CPSCourse-TUM-HN/TUM-HN-Team8_LeLamp/docs/slides/README.md

# Presentation slides

The course requires the slides **in PDF format**. Put the exported file here as:

```
docs/slides/Group8_CPS_Presentation.pdf
```

Keep the editable source (PowerPoint/Keynote/Google Slides export) next to it if you have one, e.g.
`Group8_CPS_Presentation.pptx`, so the deck can be revised later.

Suggested 15-minute structure:

1. Problem and idea (1 min)
2. System overview — hardware and software architecture (2 min)
3. What is upstream LeLamp vs. what Group 8 built (2 min)
4. Mechanical work: redesigned base, print-ready parts (2 min)
5. Perception → behaviour pipeline, voice integration (3 min)
6. Live demo / video (3 min)
7. Results, limitations, lessons learned (2 min)
