CPSCourse-TUM-HN/TUM-HN-Team8_LeLamp/docs/video/README.md

# Demonstration video

The course requires a video that demonstrates the project **in action**.

- If the file is small enough for git (< 100 MB), commit it here as
  `Group8_CPS_Demo.mp4`.
- Otherwise upload it (TUM OneDrive / YouTube unlisted / GitHub release asset) and put the link
  below, so the repository still satisfies "all materials uploaded to your GitHub repository".

**Video link:** _(to be added)_

Suggested content: powering up, camera detecting a person, the lamp reacting (motion + LED),
a voice interaction, and a short MuJoCo simulation clip showing how motions were developed.
