CPSCourse-TUM-HN/TUM-HN-Team8_LeLamp/docs/zh/0-前期准备.md

# 0. 前期准备

## 固定硬件清单

硬件型号和数量以当前使用的 profile 配置为准：Orin Nano Super 使用 `config/hardware.toml`，Jetson Nano 4GB 使用 `config/hardware.jetson-nano.toml`，不能随意替换。

默认 Orin Nano Super 配置：

| 子系统 | 型号 | 数量 |
| --- | --- | ---: |
| 主控 | NVIDIA Jetson Orin Nano Super Developer Kit, MPN `945-13766-0000-000` | 1 |
| 存储 | Samsung 980 NVMe M.2 2280 500GB, `MZ-V8V500B` | 1 |
| 系统卡 | SanDisk Ultra microSDXC 64GB UHS-I | 1 |
| 舵机 | Waveshare ST3215 Servo, 30kg.cm @ 12V, SKU `22414` | 5 |
| 舵机驱动 | Waveshare Servo Driver with ESP32, SKU `21593` | 1 |
| 舵机电源 | MEAN WELL `GST120A12-P1J`, 12V 10A 120W | 1 |
| LED 控制 | Raspberry Pi Pico WH | 1 |
| LED 面板 | Adafruit NeoPixel NeoMatrix 8x8, 64 RGB LED, Product ID `1487` | 1 |
| LED 电源 | MEAN WELL `GST60A05-P1J`, 5V 6A 30W | 1 |
| 电平转换 | TXS0108E 8-Channel Logic Level Converter Module | 1 |
| LED 电阻 | 330 ohm 1/4W resistor | 5 |
| LED 电容 | 1000 uF 6.3V or 10V electrolytic capacitor | 2 |
| 摄像头 | Arducam `UB0234`, 2MP OV2710 USB2.0 UVC Camera, 1080p, M12 lens | 1 |
| 音频 | Seeed Studio ReSpeaker XVF3800 USB 4-Mic Array with Case, Product `6490` | 1 |
| 扬声器 | Seeed Studio Mono Enclosed Speaker, 4 ohm 5W | 1 |
| 急停开关 | 12V 10A DC inline switch / emergency stop switch | 1 |
| USB 线 | USB-A to USB-C data cable, 0.5m | 1 |
| USB 线 | USB-A to Micro-USB data cable, 0.5m | 1 |
| USB 延长线 | USB-A extension cable, 0.3m or 0.5m | 1 |
| 舵机延长线 | ST / SC serial bus servo extension cable | 5 |
| 电源端子 | 5.5mm x 2.1mm DC barrel screw terminal adapter | 4 |
| 电源连接器 | WAGO 221-413 lever connector | 10 |
| 红色电源线 | 22AWG red silicone wire | 2m |
| 黑色电源线 | 22AWG black silicone wire | 2m |
| 信号线 | 24AWG silicone wire | 2m |

Jetson Nano 4GB API-hybrid 配置改动：

| 子系统 | 型号 | 数量 |
| --- | --- | ---: |
| 主控 | NVIDIA Jetson Nano Developer Kit 4GB, MPN `945-13450-0000-100` | 1 |
| 存储 | basic Jetson Nano Developer Kit 不使用 NVMe，使用 microSD 启动 | 0 |
| 系统卡 | SanDisk Ultra microSDXC 64GB UHS-I | 1 |

舵机、LED、摄像头、音频、电源、线材和连接器保持默认清单不变。

## 电源域

```text
Jetson 电源 -> 只给 Jetson
GST120A12-P1J -> Waveshare Servo Driver with ESP32 -> 5x ST3215
GST60A05-P1J -> Adafruit NeoPixel NeoMatrix 8x8
Jetson USB -> Pico WH 控制信号，不给 LED 供电
```

## 默认端口

```text
/dev/ttyACM0 -> Waveshare 舵机驱动板
/dev/ttyACM1 -> Raspberry Pi Pico WH
/dev/video0  -> Arducam UB0234
USB audio    -> ReSpeaker XVF3800
```
