CPSCourse-TUM-HN/TUM-HN-Team8_LeLamp/docs/zh/2-舵机设置.md

# 2. 舵机设置

固定 ID：

```text
base_yaw=1
base_pitch=2
elbow_pitch=3
wrist_roll=4
wrist_pitch=5
```

测试：

```bash
ailamp motor-test
```

校准沿用 LeLamp runtime：

```bash
cd ~/projects
git clone https://github.com/humancomputerlab/lelamp_runtime.git
cd ~/projects/AILamp
python3 -m pip install -e ../lelamp_runtime
python3 -m lelamp.setup_motors --id ailamp --port /dev/ttyACM0
sudo python3 -m lelamp.calibrate --id ailamp --port /dev/ttyACM0
```

ST3215 总线只使用 MEAN WELL `GST120A12-P1J` 供电，不从 Jetson USB 给舵机供电。
