CPSCourse-TUM-HN/TUM-HN-Team8_LeLamp/docs/zh/4-运行环境.md

# 4. 运行环境

```bash
cd ~/projects/AILamp
python3 -m venv .venv
source .venv/bin/activate
pip install -e ".[hardware,simulation,voice,test]"
```

Jetson Nano 4GB API-hybrid 安装：

```bash
cd ~/projects/AILamp
python3.11 -m venv .venv
source .venv/bin/activate
pip install -e ".[nano,test]"
export OPENAI_API_KEY=...
```

Jetson Nano 配置下不要在 Nano 上安装本地 YOLO pose、MuJoCo 或本地大模型。

检测：

```bash
ailamp runtime-check
ailamp hardware-check
ailamp hardware-check --include-devices
ailamp --config config/hardware.jetson-nano.toml runtime-check
ailamp --config config/hardware.jetson-nano.toml runtime-check --include-devices --include-voice
ailamp --config config/hardware.jetson-nano.toml hardware-check
ailamp --config config/hardware.jetson-nano.toml hardware-check --include-devices
```

`runtime-check` 会检查 Python 入口、动作 recording、Pico 固件文件、`outputs/` 是否可写，以及 Jetson Nano API-hybrid 配置下的 `OPENAI_API_KEY`。安装 LeLamp 上游运行时后，可以加 `--include-motor-runtime` 检查舵机运行时。

Pico WH 固件在：

```text
firmware/pico_led_controller/code.py
```

Pico WH 要求：

```text
Raspberry Pi Pico WH 使用 CircuitPython 9.x
/lib 中放入 adafruit-circuitpython-neopixel 库
NeoMatrix 数据线接 Pico GP0
Pico GP0 与 NeoMatrix DIN 之间使用 TXS0108E 电平转换
```

串口协议：

```text
PING
CLEAR
SOLID r g b
BRIGHTNESS value
PIXELS r,g,b;r,g,b
```

## Jetson Nano 验收流程

在 Jetson Nano 上按这个顺序运行：

```bash
ailamp --config config/hardware.jetson-nano.toml runtime-check
ailamp --config config/hardware.jetson-nano.toml hardware-check --include-devices
ailamp --config config/hardware.jetson-nano.toml camera-test
ailamp --config config/hardware.jetson-nano.toml audio-test
ailamp --config config/hardware.jetson-nano.toml led-test
ailamp --config config/hardware.jetson-nano.toml motor-test
ailamp --config config/hardware.jetson-nano.toml agent-tools-test --event person_right --offset 0.6 --request "看着我并跟随我"
ailamp --config config/hardware.jetson-nano.toml vision-loop --frames 30
```

全部通过后再运行真实输出：

```bash
ailamp --config config/hardware.jetson-nano.toml vision-loop --with-outputs
ailamp --config config/hardware.jetson-nano.toml agent --with-outputs
```
