CPSCourse-TUM-HN/TUM-HN-Team8_LeLamp/docs/zh/5-控制视觉仿真.md

# 5. 控制、视觉与仿真

仿真：

```bash
ailamp sim-check
ailamp sim-check --render outputs/sim_check.png
ailamp sim-check --render outputs/ailamp_current_mesh_sim.png --camera ailamp_overview_camera
ailamp sim-demo
ailamp sim-viewer --render outputs/ailamp.png
```

AILamp 保持原 LeLamp 的仿真流程：

```text
仿真软件：MuJoCo
主场景：simulation/ailamp_scene.xml
原始参考场景：simulation/scene.xml
机器人 MJCF：simulation/ailamp_robot.xml，从 `simulation/robot.xml` 生成并移除原始底座 mesh
参考 URDF：simulation/robot.urdf
网格资产：simulation/assets/*.stl
```

`simulation/ailamp_scene.xml` 包含派生的 LeLamp MJCF、虚拟人物目标、仿真摄像头，以及用于 Jetson Nano 开发板的 AILamp 替换底座。派生 MJCF 会移除原 `lamp_base` 和 `lamp_base_cover` mesh。固定壳体/上盖保留在 scene 中，`ailamp_base_arm_link_boot_visual` 会插回原 LeLamp 上盖 transform，让灯臂根部有一个随动过渡件，而不是直接穿过固定开口。

场景中的适配件可视对象：

```text
ailamp_integrated_base_shell_visual -> 替换版 LampBase 电子仓壳体
ailamp_integrated_base_cover_visual -> 替换版 LampBase 上盖
ailamp_base_arm_link_boot_visual -> 随动底座-灯臂过渡靴
ailamp_cable_clip_6mm_visual -> USB/信号线夹
ailamp_cable_clip_10mm_visual -> 电源/舵机线夹
```

这些适配件 mesh 只作为底座电子件布局参考，不改变 LeLamp 舵机运动链、灯头几何或 actuator 映射。

整体台灯渲染使用 `ailamp_overview_camera`，虚拟人物交互视角使用 `ailamp_sim_camera`。

`sim-check` 是推荐的非交互仿真验收命令，会检查模型加载、5 个 actuator 映射、root freejoint 锁定、适配件可视几何、虚拟人物事件和核心 recording 回放。

真实硬件：

```bash
ailamp camera-test
ailamp audio-test
ailamp led-test
ailamp vision-demo
ailamp vision-loop --frames 30
ailamp vision-loop --with-outputs
ailamp agent-tools-test --event person_close --apply
ailamp agent-tools-test --event posture_studying --apply
ailamp agent-tools-test --event person_right --offset 0.6 --request "看着我并跟随我" --apply
ailamp agent
ailamp agent --with-outputs
```

事件映射：

```text
no_person -> scanning -> 深蓝
person_left -> headshake -> 蓝色
person_center -> nod -> 暖色
person_right -> scanning -> 蓝色
person_close -> shy -> 粉红
person_far -> curious -> 绿色
person_left_seat -> idle -> 深蓝
gesture_left -> headshake -> 蓝色
gesture_right -> scanning -> 蓝色
gesture_up -> curious -> 冷白蓝
gesture_down -> idle -> 冷白蓝
posture_studying -> idle -> 专注暖白
looking_at_lamp -> nod -> 暖色
expression_smile -> happy_wiggle -> 暖色
expression_tired -> idle -> 专注暖白
expression_neutral -> idle -> 冷白蓝
```

`vision-demo` 只抓取一帧，打印识别事件、动作和灯光颜色。

`vision-loop` 是连续运行的真实闭环。

Orin 配置：

```text
Arducam UB0234 -> YOLO nano + YOLO pose -> VisionEvent -> DecisionService -> ST3215 + Pico LED
```

Jetson Nano API-hybrid 配置：

```text
Arducam UB0234 -> 低频 OpenAI vision API -> VisionEvent -> DecisionService -> ST3215 + Pico LED
```

默认只打印结果并写入 `outputs/vision_state.json`。在 Jetson 上确认 `led-test` 和 `motor-test` 通过后，再使用 `--with-outputs` 驱动真实舵机和 LED。

```bash
ailamp --config config/hardware.jetson-nano.toml vision-loop --with-outputs
```

## AI 决策层

AILamp 在视觉/语音输入和硬件输出之间加入了本地决策层：

```text
VisionEvent + 可选语音请求 -> DecisionService -> 动作 recording 或关节增量 + LED
```

连续跟随决策：

```text
person_left / gesture_left -> base_yaw 负向增量，慢慢向左
person_right / gesture_right -> base_yaw 正向增量，慢慢向右
person_close -> wrist_pitch 负向增量，灯头轻微后仰
person_far -> wrist_pitch 正向增量，灯头前倾
gesture_up -> wrist_pitch 正向增量
gesture_down -> wrist_pitch 负向增量
```

语音意图可以覆盖默认视觉反应：

```text
"专注" / "学习" / "focus" / "study" -> idle + 专注暖白灯
"点头" / "nod" -> nod
"跟随" / "看着我" / "follow" / "track" -> 连续跟随
"休息" / "待机" / "idle" / "rest" -> idle
```

关节增量命令在发送给 ST3215 层前会经过安全限幅。

当前手势与姿态支持使用启发式规则：

- 手向左/右/上/下会触发对应方向的灯位调整反应
- 低头学习会开启专注暖白灯光
- 抬头看台灯会触发点头回应
- 人靠近镜头优先触发 `shy`
- 人离开座位会切换到 `idle`

如果希望 AI 工具使用实时摄像头状态，需要同时运行 `vision-loop` 和 `agent`。LiveKit/OpenAI agent 读取同一个 `outputs/vision_state.json`，工具能力包括：

`ailamp agent` 默认使用 dry-run 动作和灯光输出。只有在 Jetson Nano 硬件验收流程通过后，才使用 `ailamp agent --with-outputs` 驱动真实硬件。

- 描述可用工具
- 根据视觉和语音意图做决策
- 读取当前视觉状态
- 给出当前视觉状态对应的动作和灯光
- 将当前视觉行为应用到真实台灯
- 列出可用动作 recording
- 播放指定动作 recording
- 设置自定义 LED 颜色

`agent-tools-test` 会调用同一套 AI 可用工具，不需要 LiveKit 或真实硬件，默认使用 dry-run 输出：

```bash
ailamp agent-tools-test --event person_close --apply --recording nod --color 1 2 3
ailamp agent-tools-test --event posture_studying --apply
ailamp agent-tools-test --event person_right --offset 0.6 --request "看着我并跟随我" --apply
```
