CPSCourse-TUM-HN/TUM-HN-Team8_LeLamp/docs/zh/7-生日提醒.md

# 7. 生日提醒

AILamp 不使用隐藏后门。生日提醒是显式配置项，位于 `config/hardware.toml`：

```toml
[birthday]
enabled = true
month = 5
day = 8
message = "Happy birthday, Yugu!"
motion = "happy_wiggle"
rgb = [255, 180, 80]
state_file = "outputs/birthday_state.json"
speech_command = "auto"
```

本地测试：

```bash
ailamp birthday-check --today 2026-05-08 --dry-run
ailamp birthday-check --today 2026-05-08 --force --speak
```

Jetson 自动运行：

```bash
sudo cp deploy/systemd/ailamp-birthday.service /etc/systemd/system/
sudo cp deploy/systemd/ailamp-birthday.timer /etc/systemd/system/
sudo systemctl daemon-reload
sudo systemctl enable --now ailamp-birthday.timer
```

部署前把 service 文件中的 `/opt/AILamp` 改成实际项目路径。timer 每天运行一次，CLI 只会在配置日期触发，并通过 `state_file` 防止同一天重复播放。
