CPSCourse-TUM-HN/TUM-HN-Team8_LeLamp/TEAM.md

# Group 8 — team and roles

| Name | TUM e-mail | GitHub | Responsibility |
|---|---|---|---|
| Yu Gu | yu.gu@tum.de | YuGu0358 | *(fill in)* |
| *(name)* | | | |
| *(name)* | | | |
| *(name)* | | | |
| *(name)* | | | |
| *(name)* | | | |
| *(name)* | | | |

Course: Embedded Systems, Cyber-Physical Systems and Robotics (INHN0018), TUM Campus Heilbronn, S2026.
Teaching team: Prof. Amr Alanwar · Hadi Elnemr · Moaaz Eid · Ahmad Hafez · Peng Xie.
