CPSCourse-TUM-HN/TUM-HN-Team8_LeLamp/docs/media/ailamp_mujoco_topdown.png

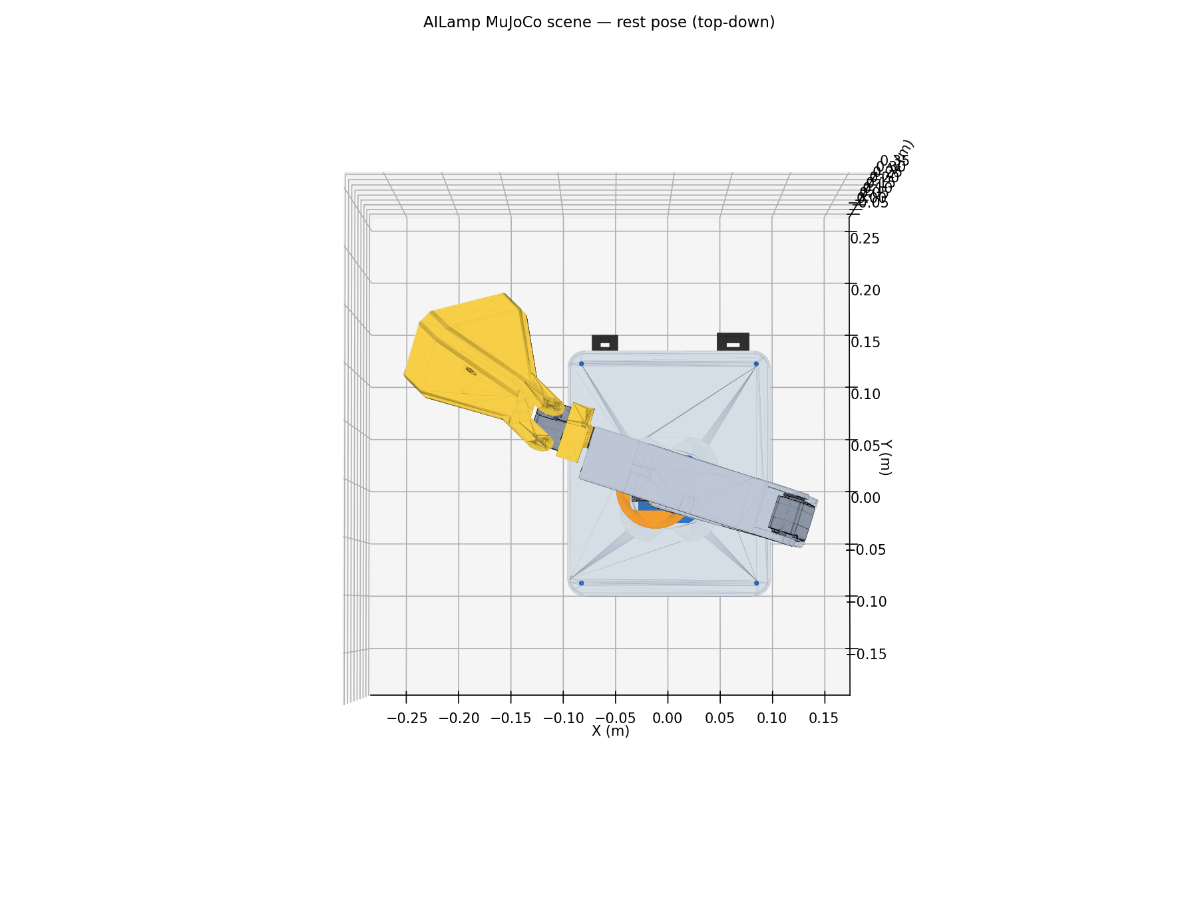
docs/media/ailamp_mujoco_topdown.png
