CPSCourse-TUM-HN/TUM-HN-Team8_LeLamp/docs/media/ailamp_optimized_base_exploded.png

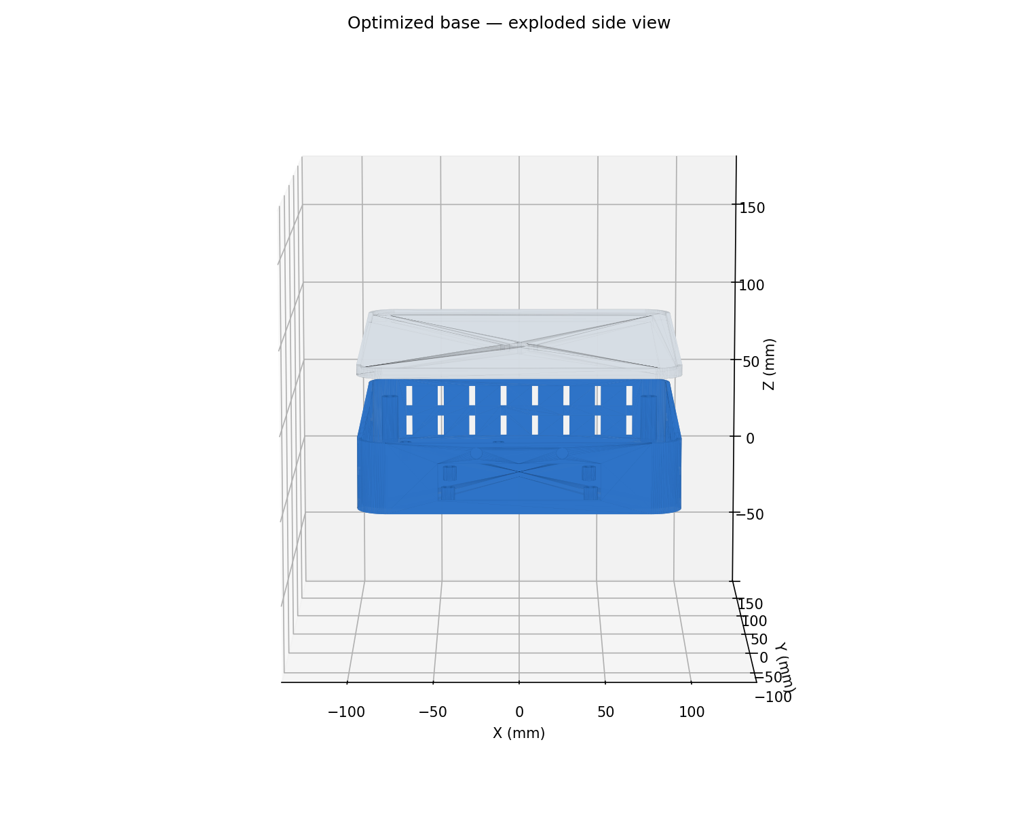
docs/media/ailamp_optimized_base_exploded.png
