CPSCourse-TUM-HN/TUM-HN-Team8_LeLamp/docs/media/ailamp_optimized_shell_cavity.png

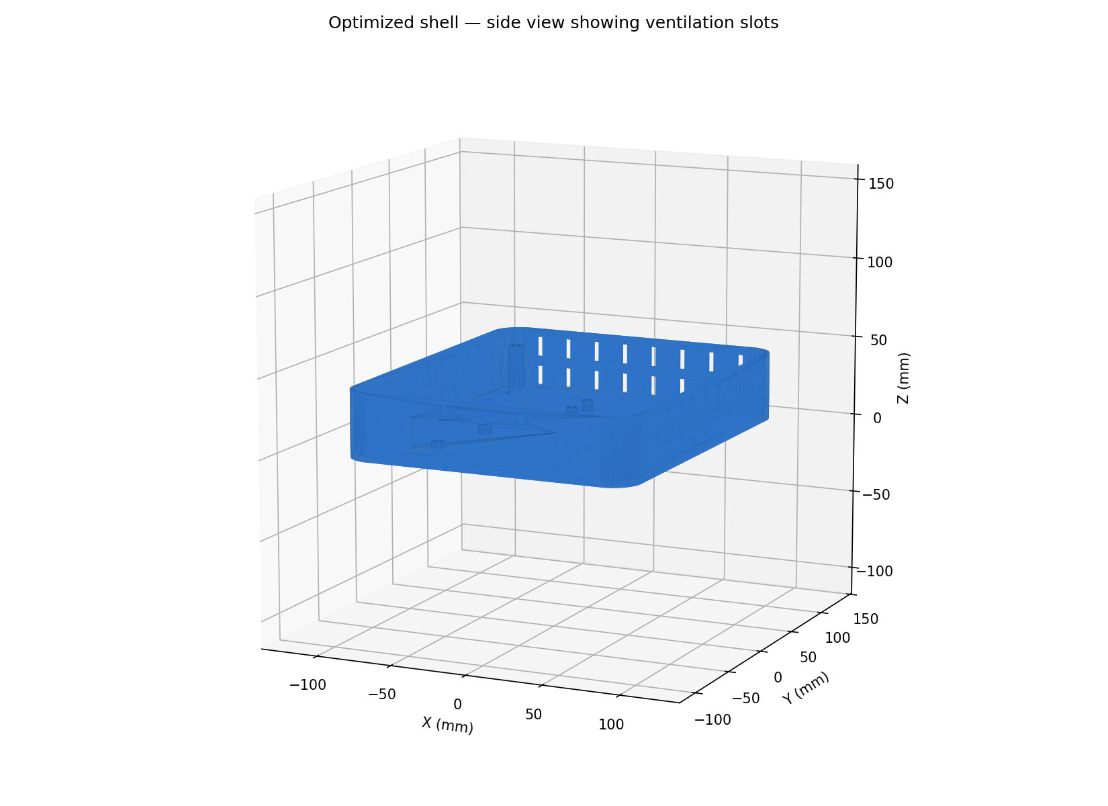
docs/media/ailamp_optimized_shell_cavity.png
