CPSCourse-TUM-HN/TUM-HN-Team8_LeLamp/docs/media/pose_idle.png

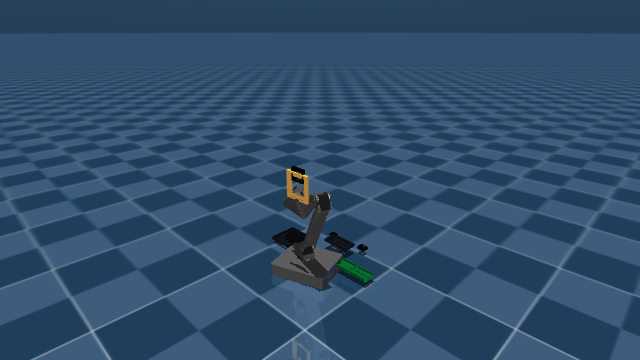
docs/media/pose_idle.png
