CPSCourse-TUM-HN/TUM-HN-Team8_LeLamp/3D/AILamp_Adapters/AILamp_Electronics_Side_Deck.3mf

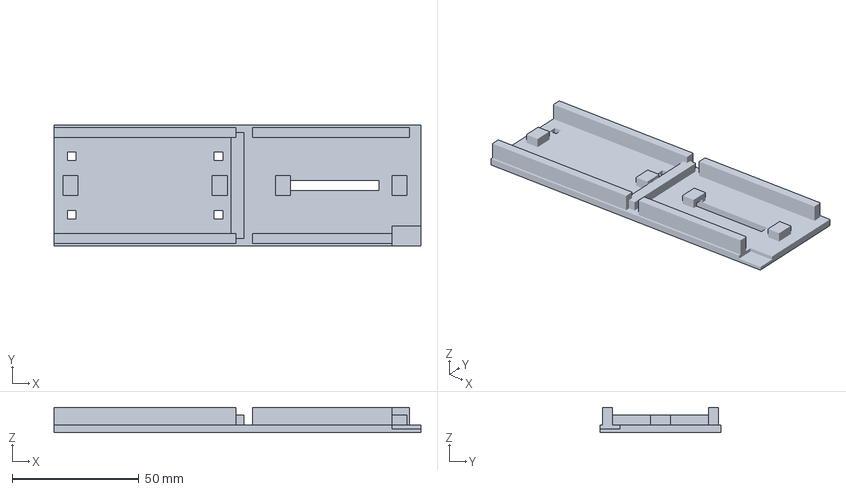
[picture p7: CAD file, 2026-08-31]
3D/AILamp_Adapters/AILamp_Electronics_Side_Deck.3mf
145.0 x 48.0 x 10.0 mm
