CPSCourse-TUM-HN/TUM-HN-Team8_LeLamp/3D/LampBase.3mf

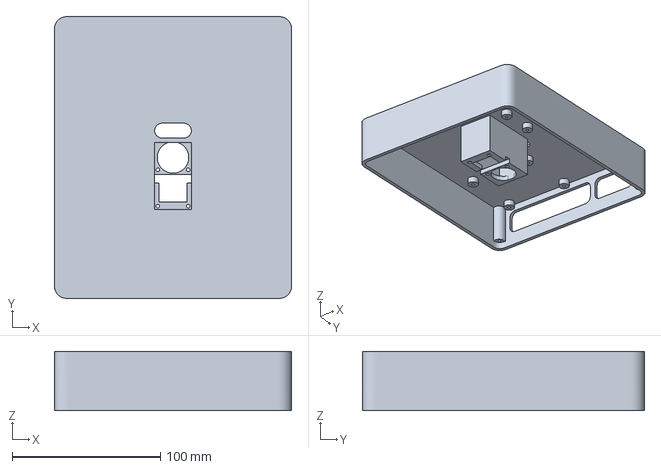
[picture p8: CAD file, 2026-08-31]
3D/LampBase.3mf
160.0 x 190.0 x 40.0 mm
