CPSCourse-TUM-HN/TUM-HN-Team8_LeLamp/3D/print_ready/AILamp_Current_3D_Print_Files/Required_3MF/LampHead.3mf

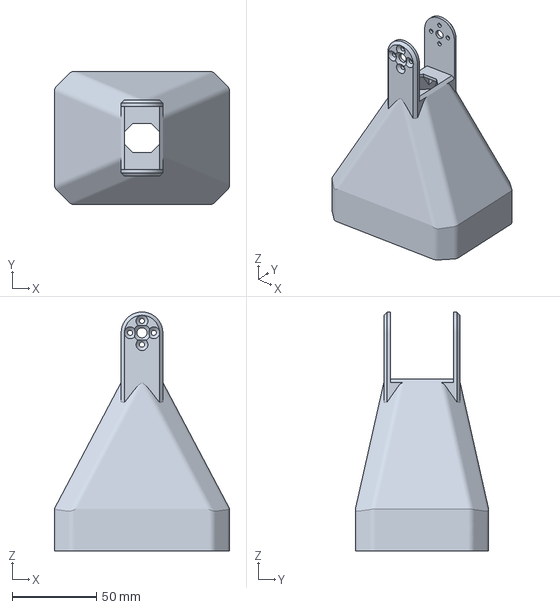
[picture p9: CAD file, 2026-08-31]
3D/print_ready/AILamp_Current_3D_Print_Files/Required_3MF/LampHead.3mf
104.0 x 79.0 x 141.7 mm
