CPSCourse-TUM-HN/TUM-HN-Team8_LeLamp/simulation/assets/ge_27.stl

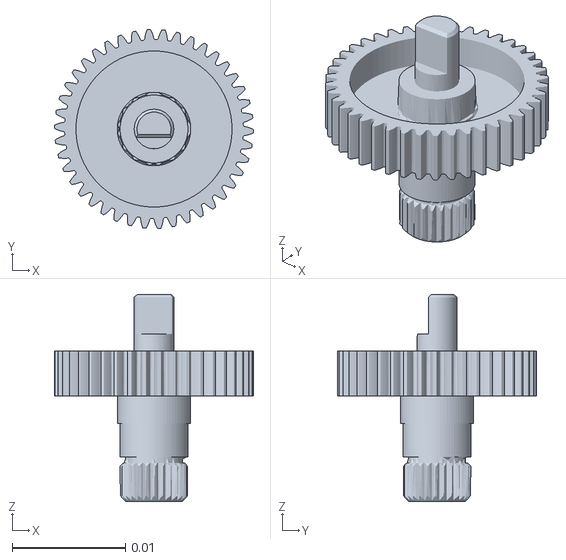
[picture p10: CAD file, 2026-08-31]
simulation/assets/ge_27.stl
0.0176 x 0.0176 x 0.0183
