CPSCourse-TUM-HN/TUM-HN-Team8_LeLamp/3D/AILamp_Adapters/AILamp_Base_Arm_Link_Boot.3mf

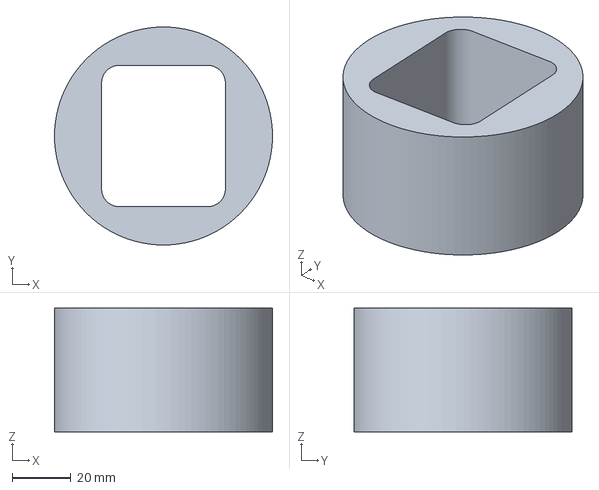
[picture p11: CAD file, 2026-08-31]
3D/AILamp_Adapters/AILamp_Base_Arm_Link_Boot.3mf
74.0 x 74.0 x 42.0 mm
