CPSCourse-TUM-HN/TUM-HN-Team8_LeLamp/3D/LampBase - Cover.3mf

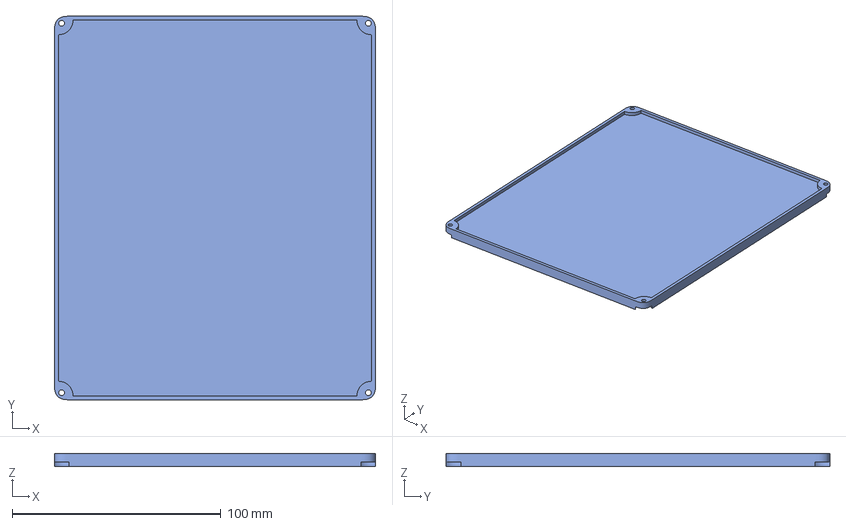
[picture p12: CAD file, 2026-08-31]
3D/LampBase - Cover.3mf
153.8 x 183.8 x 6.00 mm
