CPSCourse-TUM-HN/TUM-HN-Team8_LeLamp/3D/print_ready/AILamp_Current_3D_Print_Files/Optional_3MF/AILamp_Jetson_Nano_Base_Tray.3mf

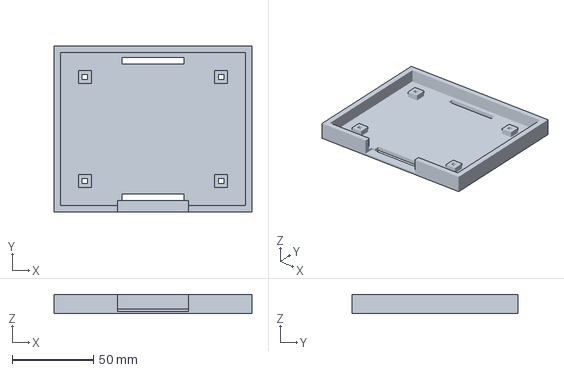
[picture p13: CAD file, 2026-08-31]
3D/print_ready/AILamp_Current_3D_Print_Files/Optional_3MF/AILamp_Jetson_Nano_Base_Tray.3mf
122.0 x 102.0 x 12.0 mm
