CPSCourse-TUM-HN/TUM-HN-Team8_LeLamp/3D/print_ready/AILamp_Current_3D_Print_Files/Required_3MF/AILamp_LampBase_Electronics_Cover.3mf

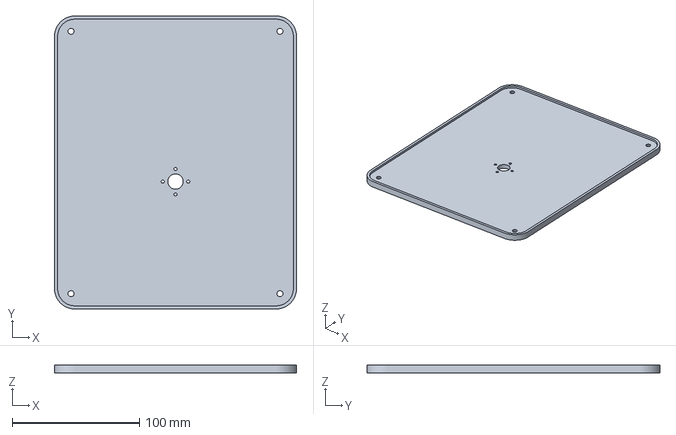
[picture p14: CAD file, 2026-08-31]
3D/print_ready/AILamp_Current_3D_Print_Files/Required_3MF/AILamp_LampBase_Electronics_Cover.3mf
190.0 x 230.0 x 6.00 mm
