CPSCourse-TUM-HN/TUM-HN-Team8_LeLamp/3D/print_ready/AILamp_Current_3D_Print_Files/STL_Exports/AILamp_LampBase_Electronics_Shell.stl

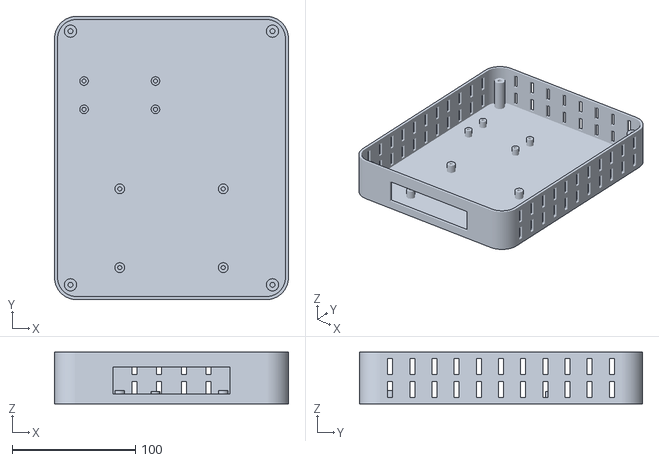
[picture p15: CAD file, 2026-08-31]
3D/print_ready/AILamp_Current_3D_Print_Files/STL_Exports/AILamp_LampBase_Electronics_Shell.stl
190.0 x 230.0 x 42.0
