CPSCourse-TUM-HN/TUM-HN-Team8_LeLamp/simulation/assets/ailamp_adapters/AILamp_Cable_Clip_6mm.stl

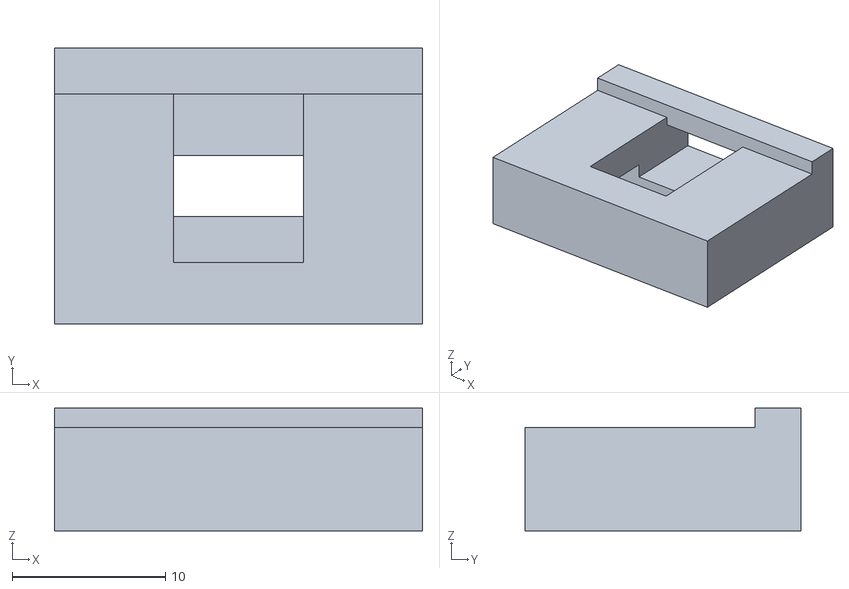
[picture p16: CAD file, 2026-08-31]
simulation/assets/ailamp_adapters/AILamp_Cable_Clip_6mm.stl
24.0 x 18.0 x 8.00
