CPSCourse-TUM-HN/TUM-HN-Team8_LeLamp/simulation/assets/motor_1723_3.stl

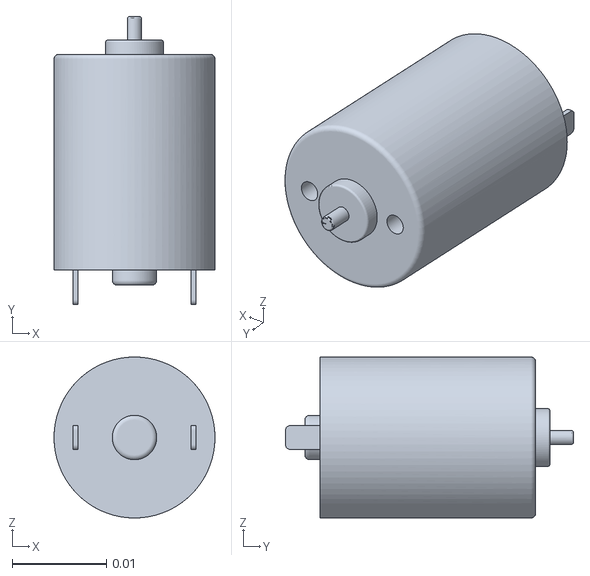
[picture p17: CAD file, 2026-08-31]
simulation/assets/motor_1723_3.stl
0.017 x 0.0305 x 0.017
