CPSCourse-TUM-HN/TUM-HN-Team8_LeLamp/3D/LampArm (Pitch).3mf

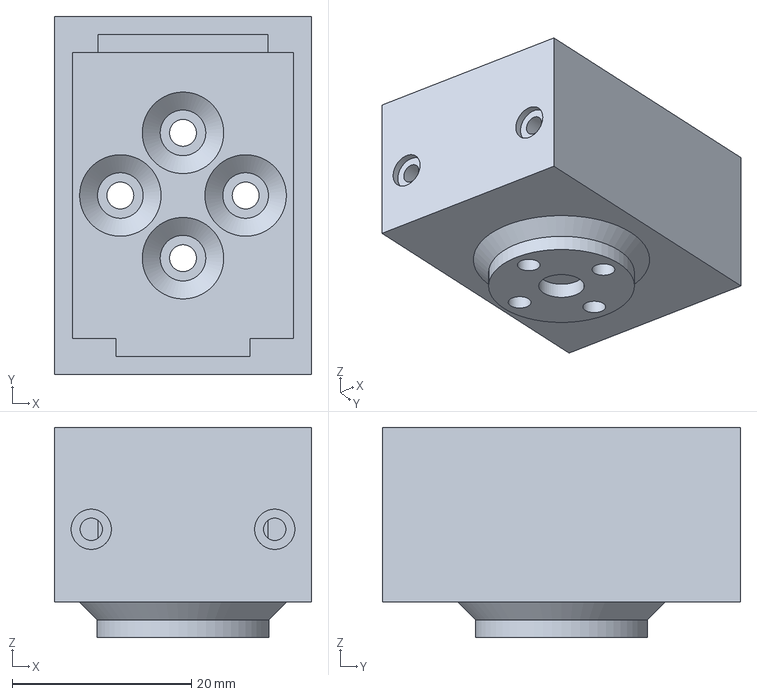
[picture p18: CAD file, 2026-08-31]
3D/LampArm (Pitch).3mf
28.7 x 40.0 x 23.5 mm
