CPSCourse-TUM-HN/TUM-HN-Team8_LeLamp/3D/print_ready/AILamp_Current_3D_Print_Files/Required_3MF/LampHead - Diffuser.3mf

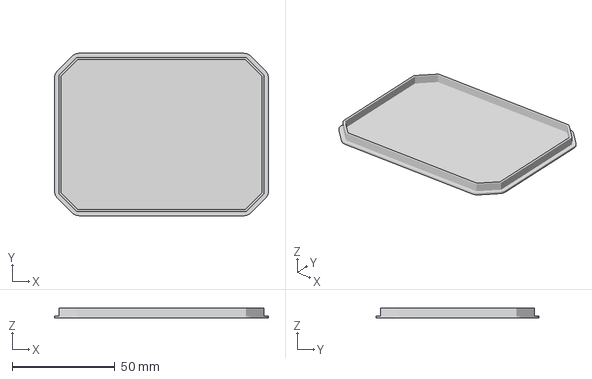
[picture p19: CAD file, 2026-08-31]
3D/print_ready/AILamp_Current_3D_Print_Files/Required_3MF/LampHead - Diffuser.3mf
104.0 x 79.0 x 5.00 mm
