CPSCourse-TUM-HN/TUM-HN-Team8_LeLamp/3D/print_ready/AILamp_Current_3D_Print_Files/STL_Exports/AILamp_Cable_Clip_10mm.stl

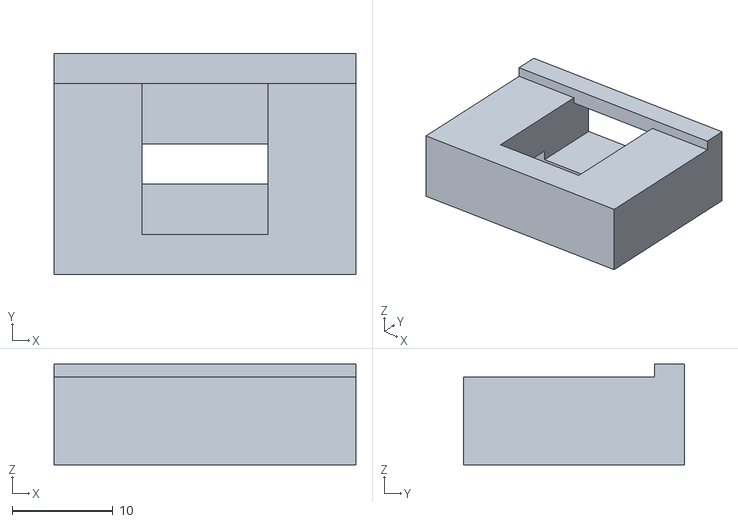
[picture p20: CAD file, 2026-08-31]
3D/print_ready/AILamp_Current_3D_Print_Files/STL_Exports/AILamp_Cable_Clip_10mm.stl
30.0 x 22.0 x 10.0
