CPSCourse-TUM-HN/TUM-HN-Team8_LeLamp/simulation/assets/xg_ziji_16.stl

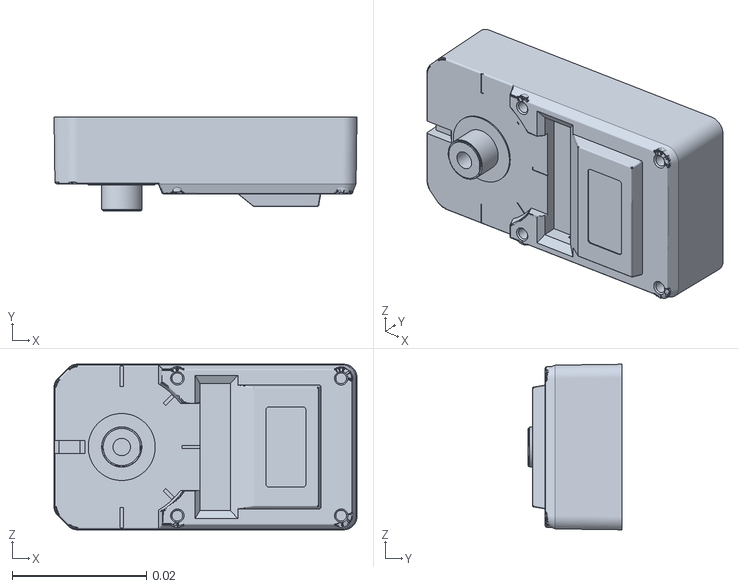
[picture p21: CAD file, 2026-08-31]
simulation/assets/xg_ziji_16.stl
0.0452 x 0.0141 x 0.0247
