CPSCourse-TUM-HN/TUM-HN-Team8_LeLamp/3D/LampArm (Elbow-Wrist).3mf

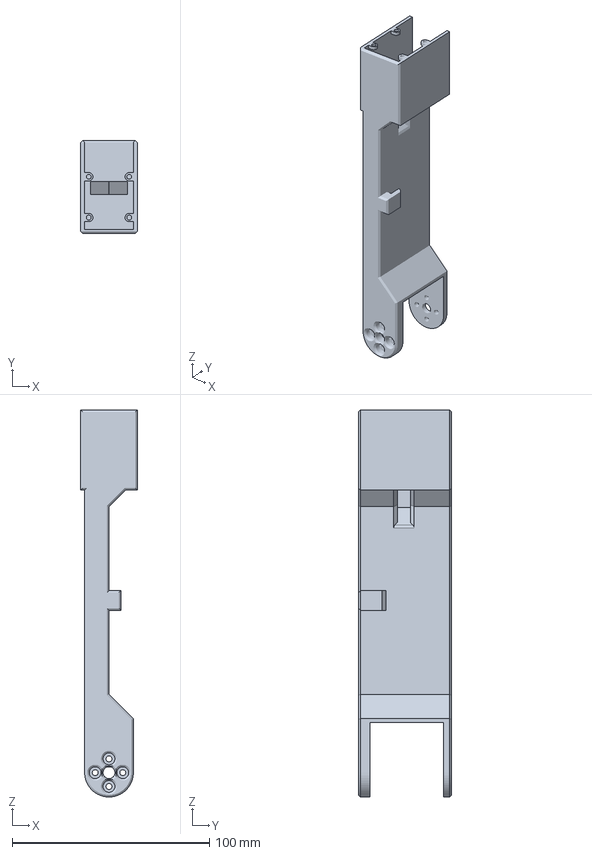
[picture p22: CAD file, 2026-08-31]
3D/LampArm (Elbow-Wrist).3mf
28.7 x 47.2 x 196.3 mm
