CPSCourse-TUM-HN/TUM-HN-Team8_LeLamp/3D/print_ready/AILamp_Current_3D_Print_Files/Required_3MF/LampArm (Base-Elbow).3mf

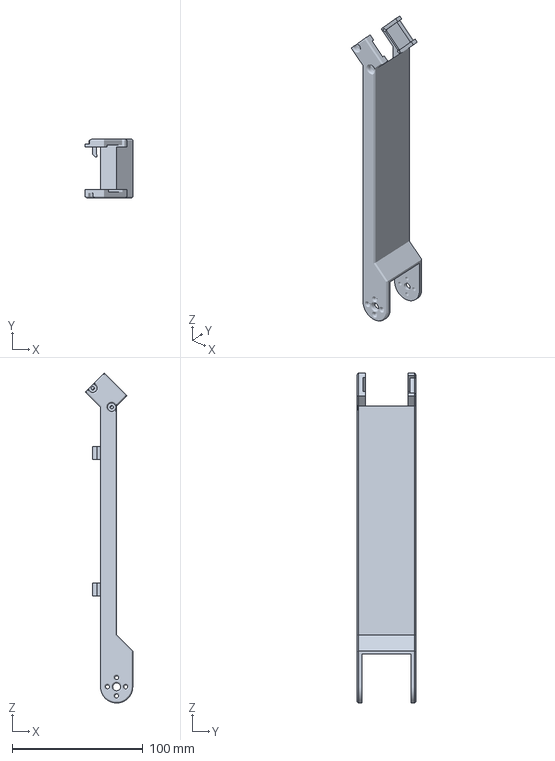
[picture p23: CAD file, 2026-08-31]
3D/print_ready/AILamp_Current_3D_Print_Files/Required_3MF/LampArm (Base-Elbow).3mf
36.4 x 45.2 x 252.7 mm
