CPSCourse-TUM-HN/TUM-HN-Team8_LeLamp/simulation/assets/diffuser.stl

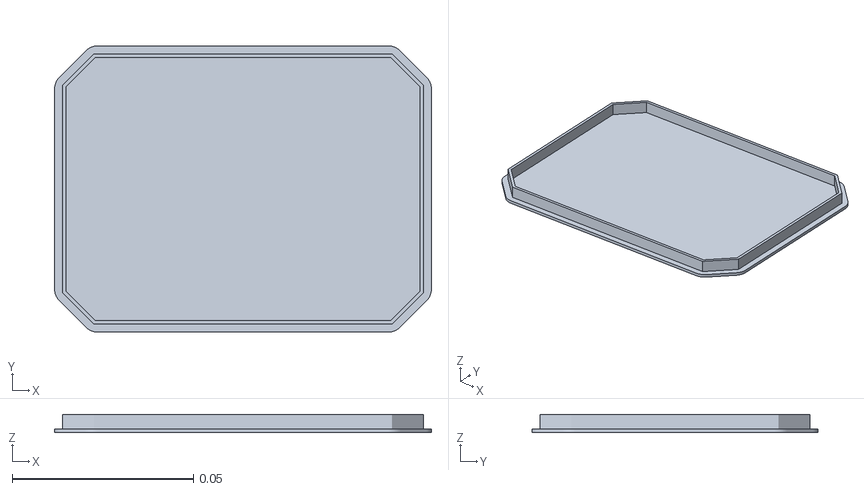
[picture p25: CAD file, 2026-08-31]
simulation/assets/diffuser.stl
0.104 x 0.079 x 0.005
