CPSCourse-TUM-HN/TUM-HN-Team8_LeLamp/3D/AILamp_Adapters/AILamp_LampBase_Electronics_Shell.3mf

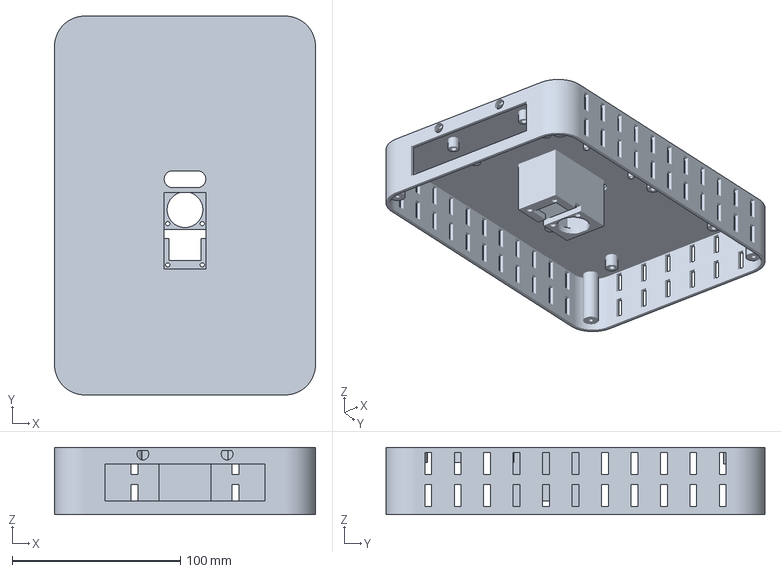
[picture p26: CAD file, 2026-08-31]
3D/AILamp_Adapters/AILamp_LampBase_Electronics_Shell.3mf
155.0 x 225.0 x 40.0 mm
