CPSCourse-TUM-HN/TUM-HN-Team8_LeLamp/simulation/assets/pcb_chazuo_92.stl

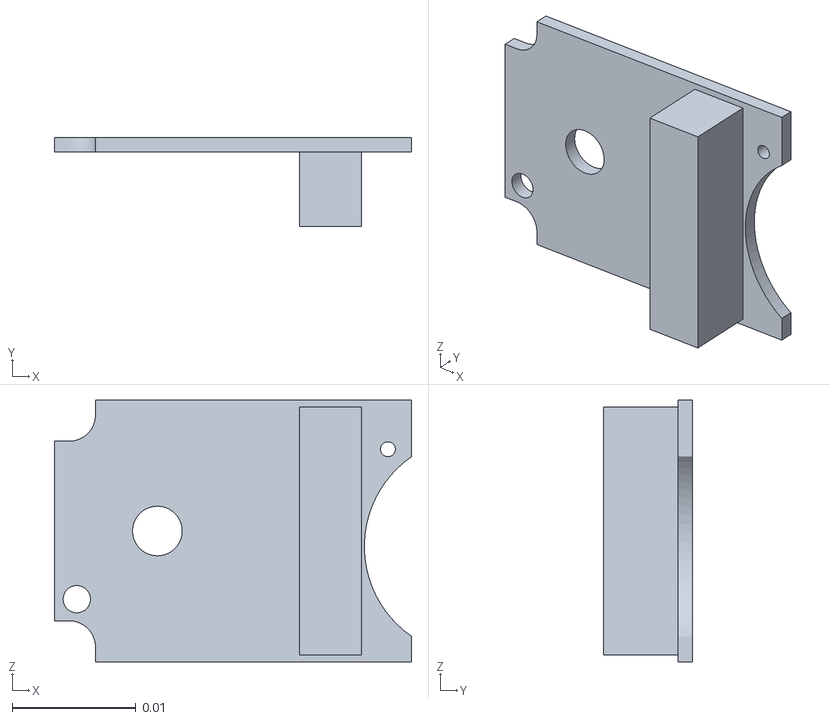
[picture p27: CAD file, 2026-08-31]
simulation/assets/pcb_chazuo_92.stl
0.0288 x 0.0072 x 0.0211
