CPSCourse-TUM-HN/TUM-HN-Team8_LeLamp/simulation/assets/ailamp_adapters/AILamp_LampBase_Electronics_Cover.stl

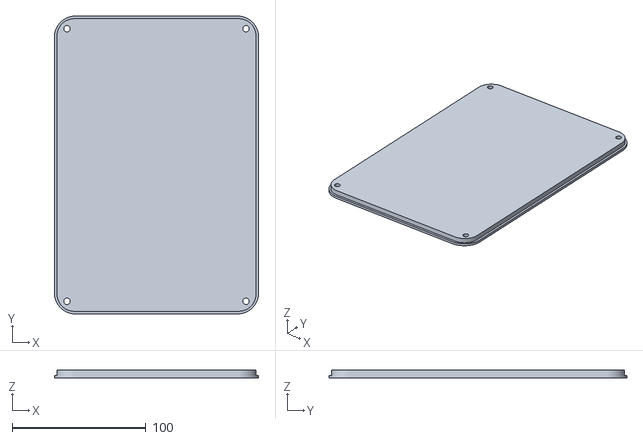
[picture p28: CAD file, 2026-08-31]
simulation/assets/ailamp_adapters/AILamp_LampBase_Electronics_Cover.stl
153.0 x 223.0 x 6.00
