CPSCourse-TUM-HN/TUM-HN-Team8_LeLamp/simulation/assets/金属舵盘_驱动__v2.stl

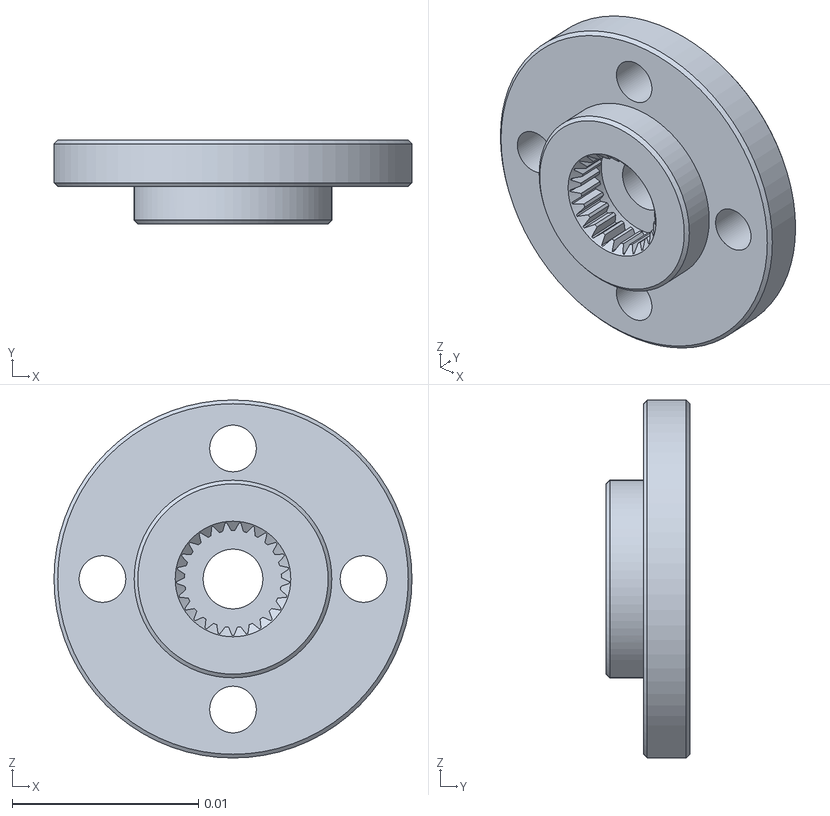
[picture p29: CAD file, 2026-08-31]
simulation/assets/金属舵盘_驱动__v2.stl
0.0192 x 0.0045 x 0.0192
