CPSCourse-TUM-HN/TUM-HN-Team8_LeLamp/simulation/assets/lamparm__wrist_head.stl

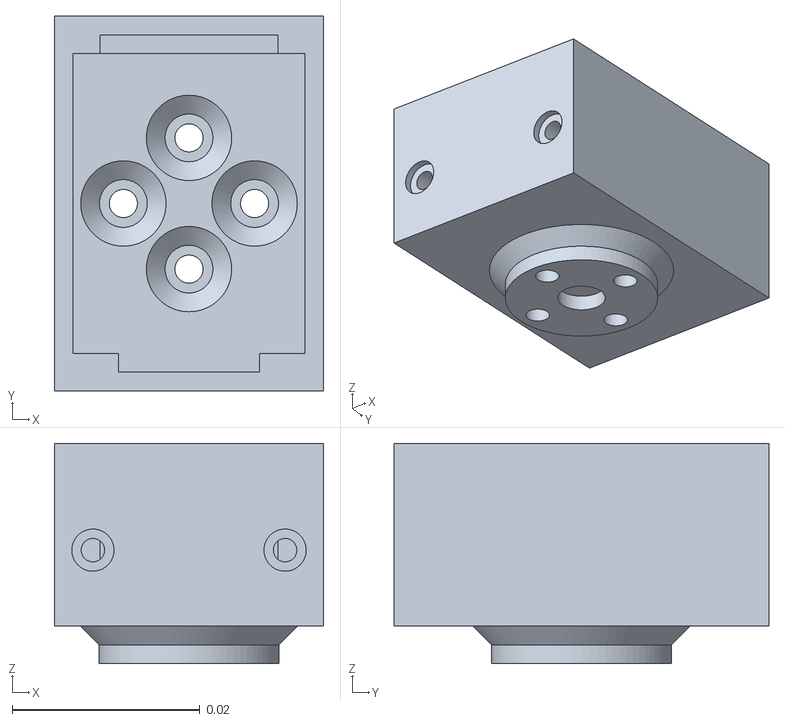
[picture p30: CAD file, 2026-08-31]
simulation/assets/lamparm__wrist_head.stl
0.0287 x 0.04 x 0.0235
