CPSCourse-TUM-HN/TUM-HN-Team8_LeLamp/simulation/assets/lamparm__base_elbow.stl

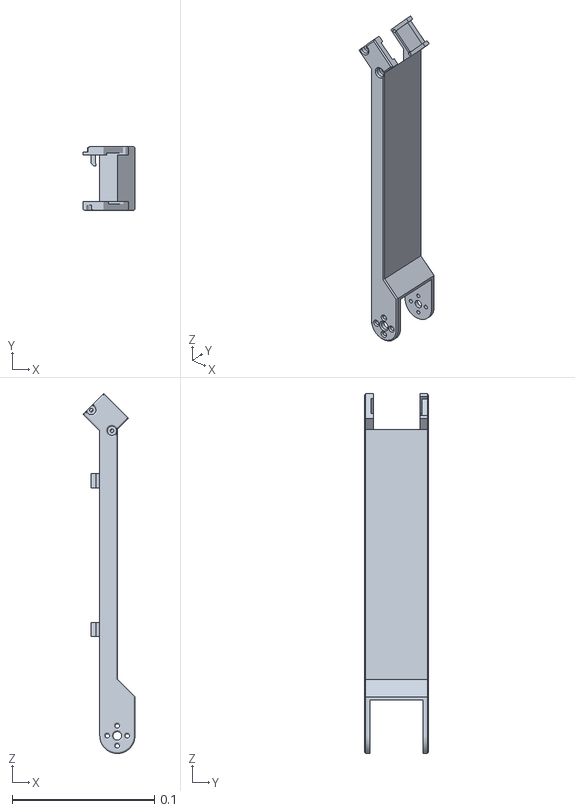
[picture p31: CAD file, 2026-08-31]
simulation/assets/lamparm__base_elbow.stl
0.0364 x 0.0452 x 0.253
