CPSCourse-TUM-HN/TUM-HN-Team8_LeLamp/simulation/assets/金属舵盘_从动__v2.stl

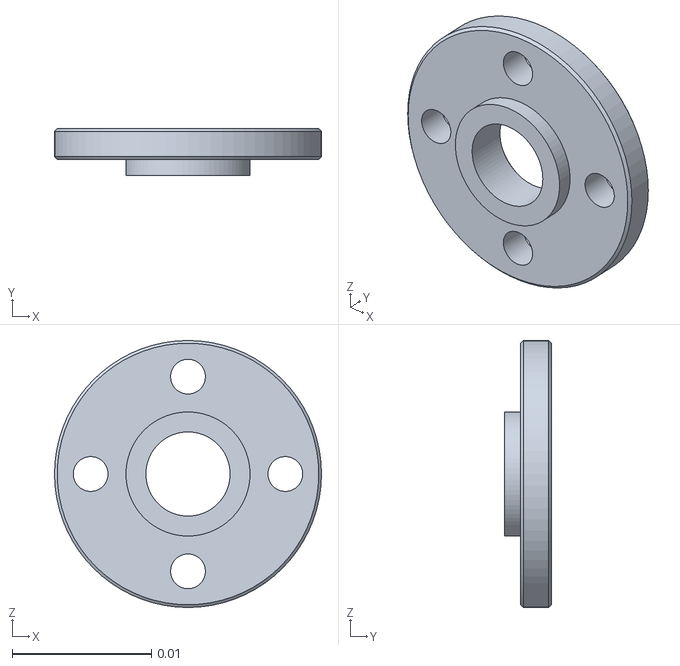
[picture p32: CAD file, 2026-08-31]
simulation/assets/金属舵盘_从动__v2.stl
0.0192 x 0.00335 x 0.0192
