CPSCourse-TUM-HN/TUM-HN-Team8_LeLamp/simulation/assets/zk_122.stl

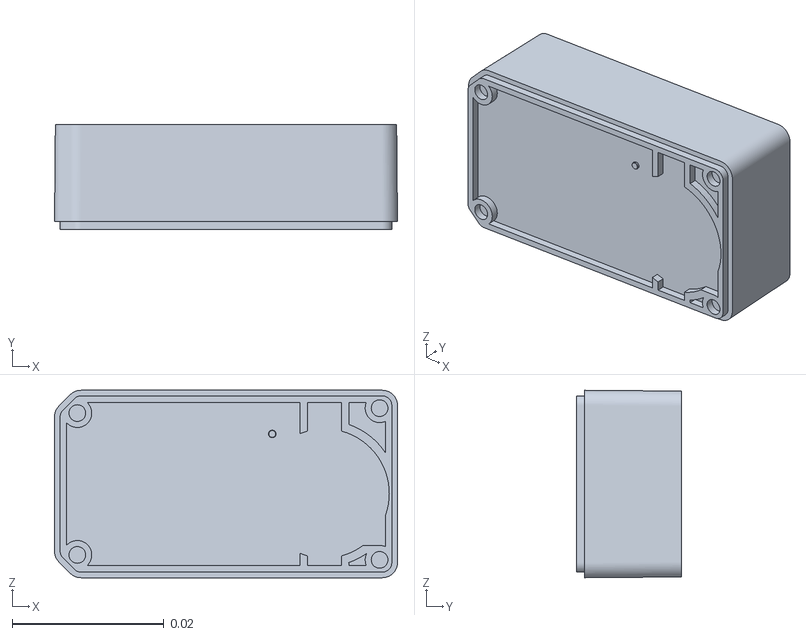
[picture p33: CAD file, 2026-08-31]
simulation/assets/zk_122.stl
0.0452 x 0.0139 x 0.0247
