CPSCourse-TUM-HN/TUM-HN-Team8_LeLamp/simulation/assets/dc15_a01_led_cap2_dummy.stl

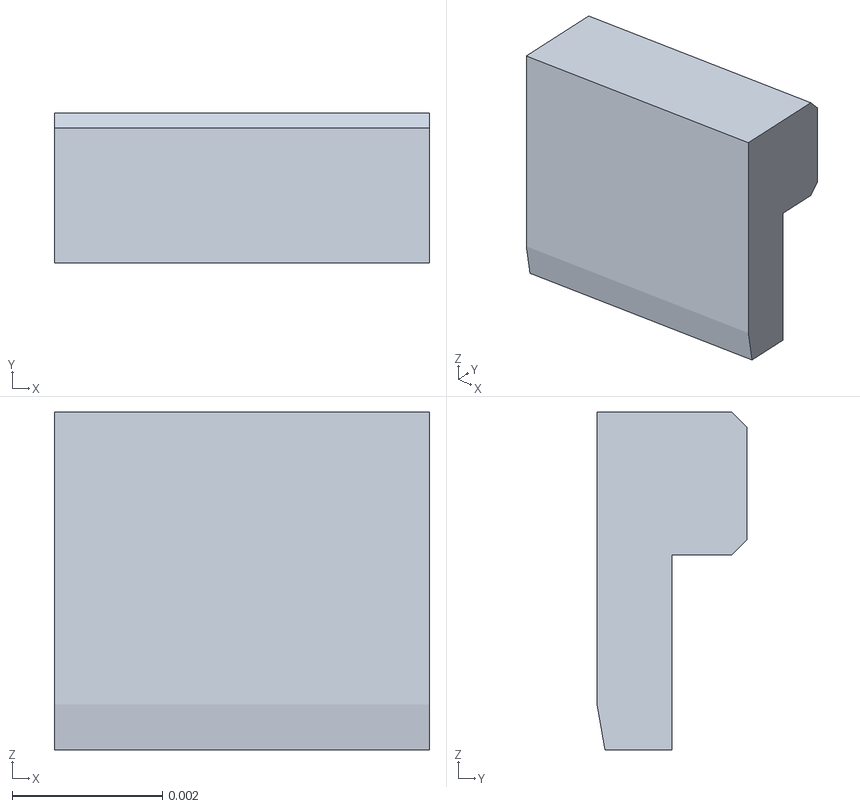
[picture p34: CAD file, 2026-08-31]
simulation/assets/dc15_a01_led_cap2_dummy.stl
0.005 x 0.002 x 0.0045
