CPSCourse-TUM-HN/TUM-HN-Team8_LeLamp/simulation/assets/arm_length_10cm.stl

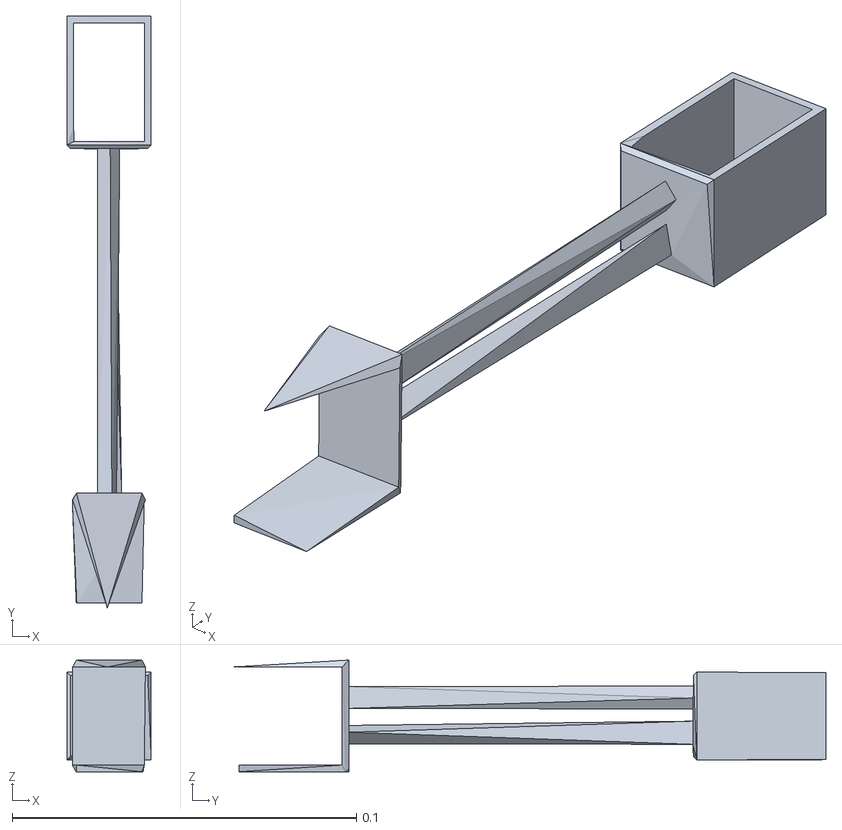
[picture p35: CAD file, 2026-08-31]
simulation/assets/arm_length_10cm.stl
0.0245 x 0.172 x 0.0325
