CPSCourse-TUM-HN/TUM-HN-Team8_LeLamp/simulation/assets/dc15_a01_case_m_dummy.stl

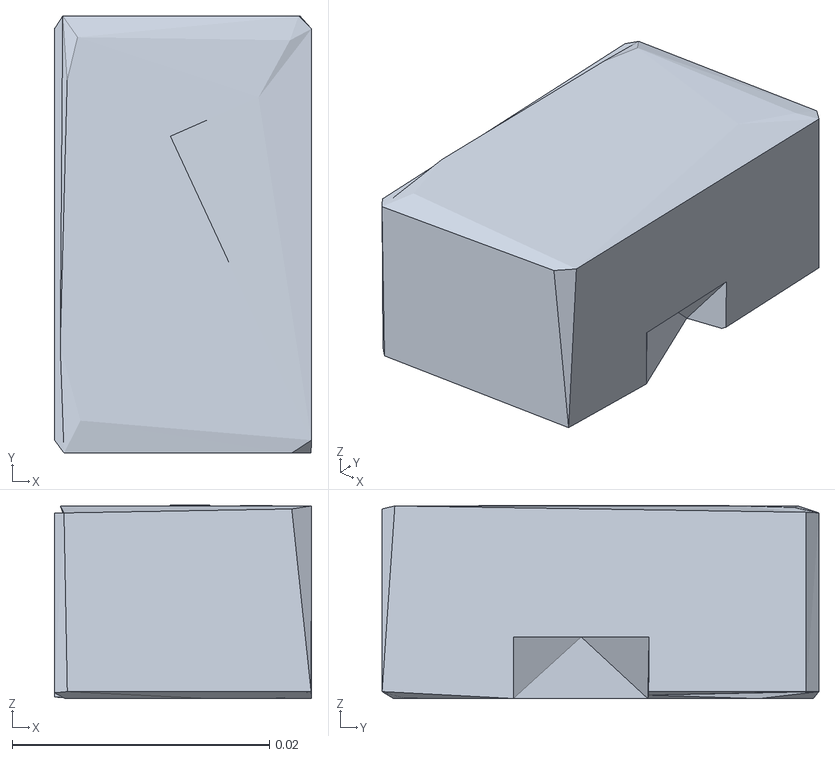
[picture p36: CAD file, 2026-08-31]
simulation/assets/dc15_a01_case_m_dummy.stl
0.02 x 0.034 x 0.015
