CPSCourse-TUM-HN/TUM-HN-Team8_LeLamp/simulation/assets/lamp_head.stl

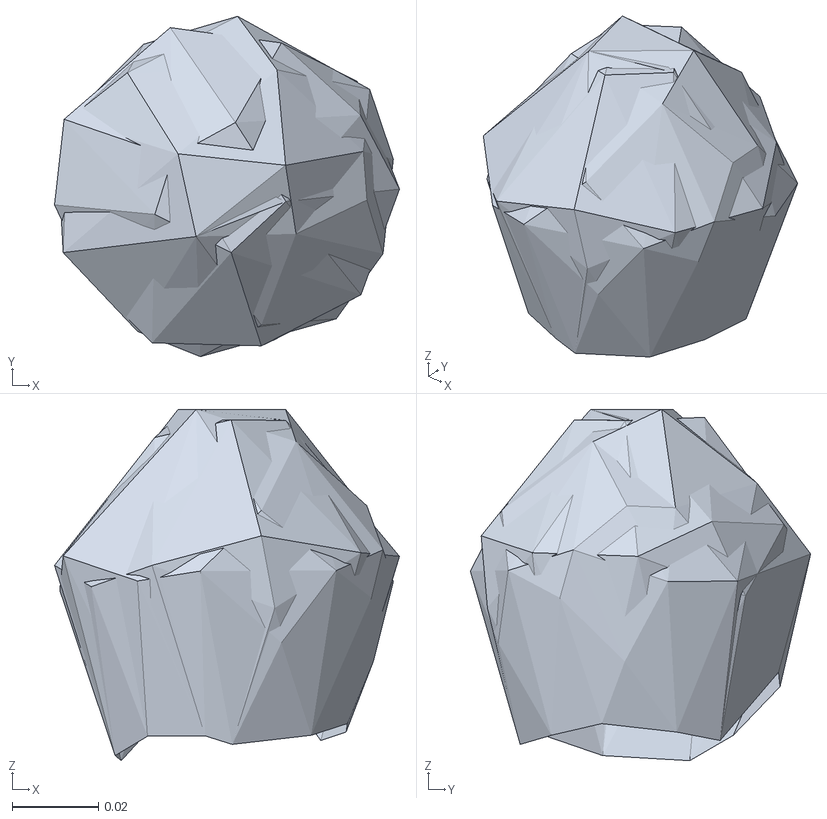
[picture p37: CAD file, 2026-08-31]
simulation/assets/lamp_head.stl
0.08 x 0.0789 x 0.0815
