CPSCourse-TUM-HN/TUM-HN-Team8_LeLamp/simulation/assets/square_joint.stl

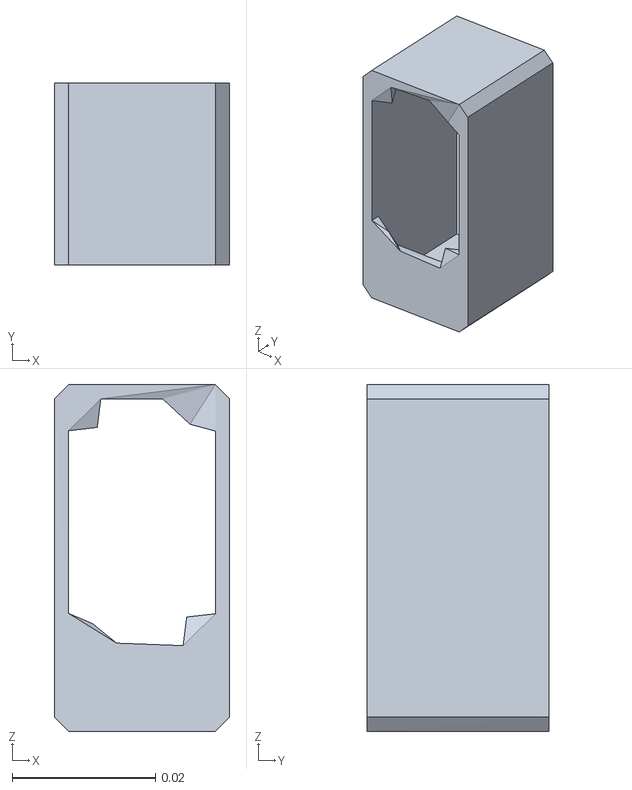
[picture p38: CAD file, 2026-08-31]
simulation/assets/square_joint.stl
0.0245 x 0.0255 x 0.0485
