CPSCourse-TUM-HN/TUM-HN-Team8_LeLamp/simulation/assets/lamp_base.stl

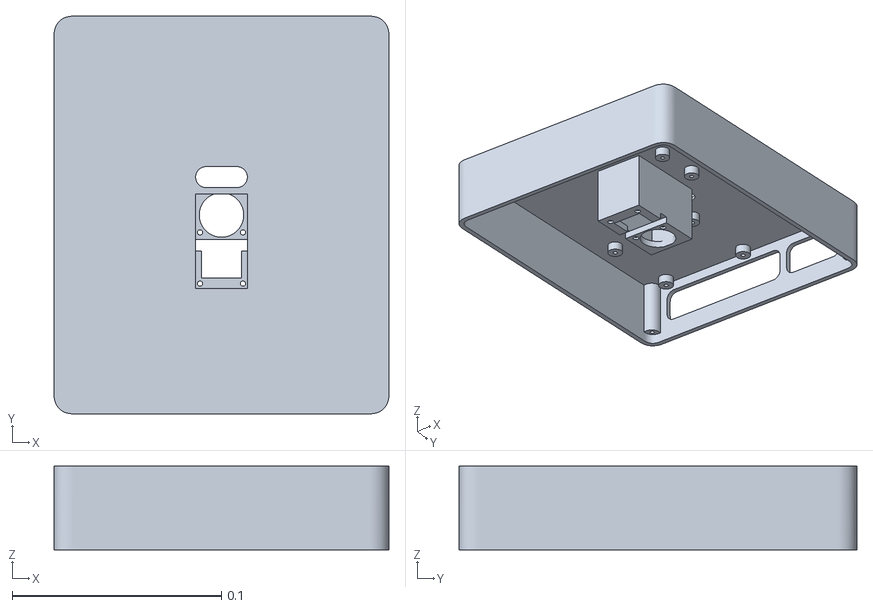
[picture p39: CAD file, 2026-08-31]
simulation/assets/lamp_base.stl
0.16 x 0.19 x 0.04
