CPSCourse-TUM-HN/TUM-HN-Team8_LeLamp/simulation/assets/dc15_a01_case_b_dummy.stl

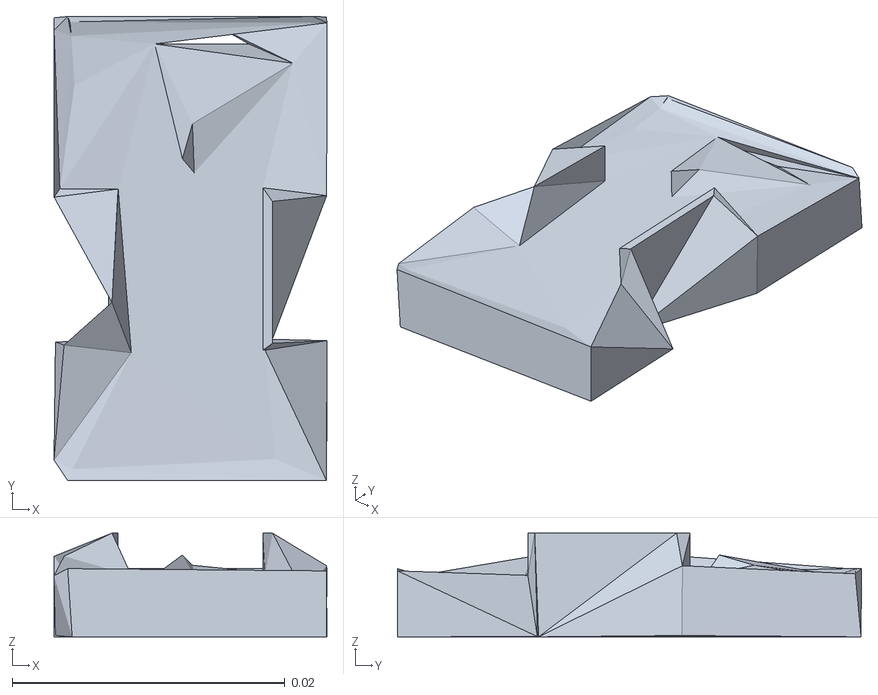
[picture p40: CAD file, 2026-08-31]
simulation/assets/dc15_a01_case_b_dummy.stl
0.02 x 0.034 x 0.0076
