CPSCourse-TUM-HN/TUM-HN-Team8_LeLamp/simulation/assets/sg_ziji_15.stl

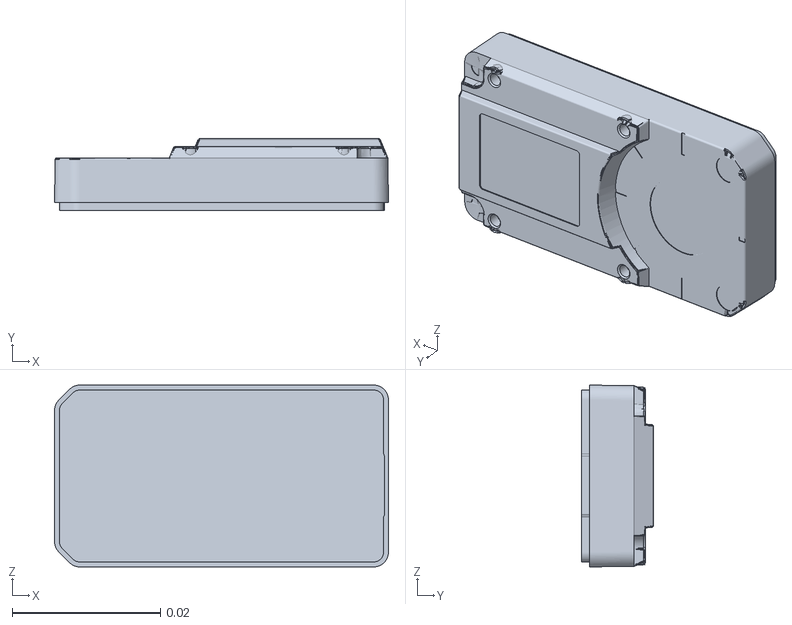
[picture p41: CAD file, 2026-08-31]
simulation/assets/sg_ziji_15.stl
0.045 x 0.0097 x 0.0245
