CPSCourse-TUM-HN/TUM-HN-Team8_LeLamp/simulation/assets/base.stl

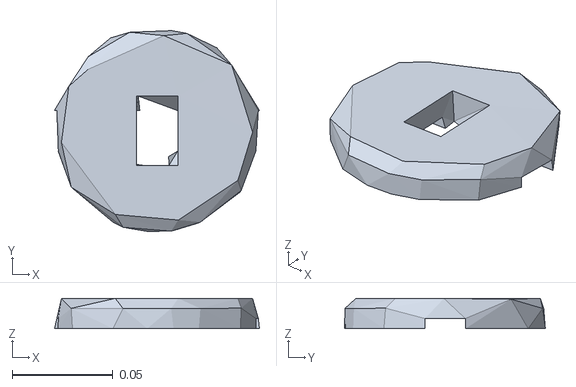
[picture p42: CAD file, 2026-08-31]
simulation/assets/base.stl
0.102 x 0.0996 x 0.015
