CPSCourse-TUM-HN/TUM-HN-Team8_LeLamp/simulation/assets/dc15_a01_horn_dummy.stl

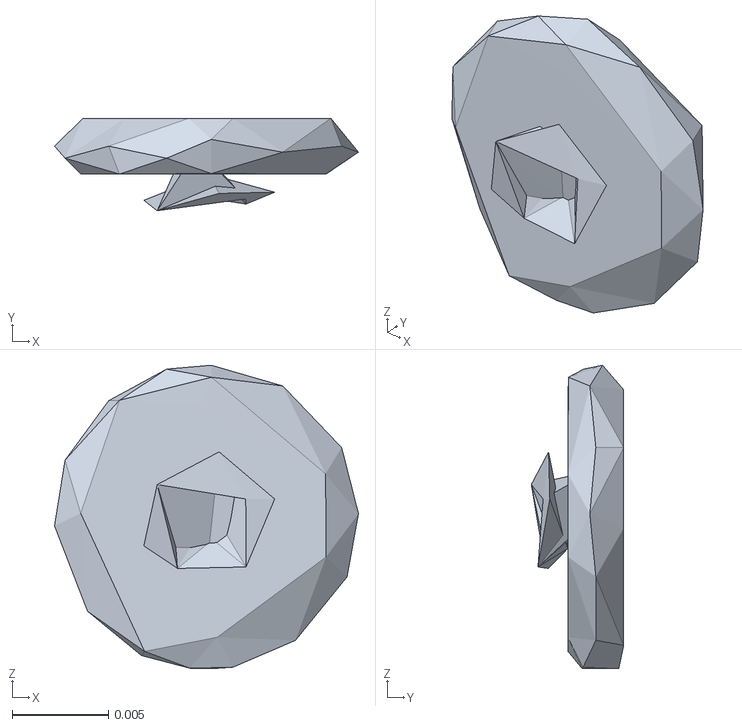
[picture p43: CAD file, 2026-08-31]
simulation/assets/dc15_a01_horn_dummy.stl
0.0158 x 0.00481 x 0.0158
