CPSCourse-TUM-HN/TUM-HN-Team8_LeLamp/simulation/assets/arm_length_15cm.stl

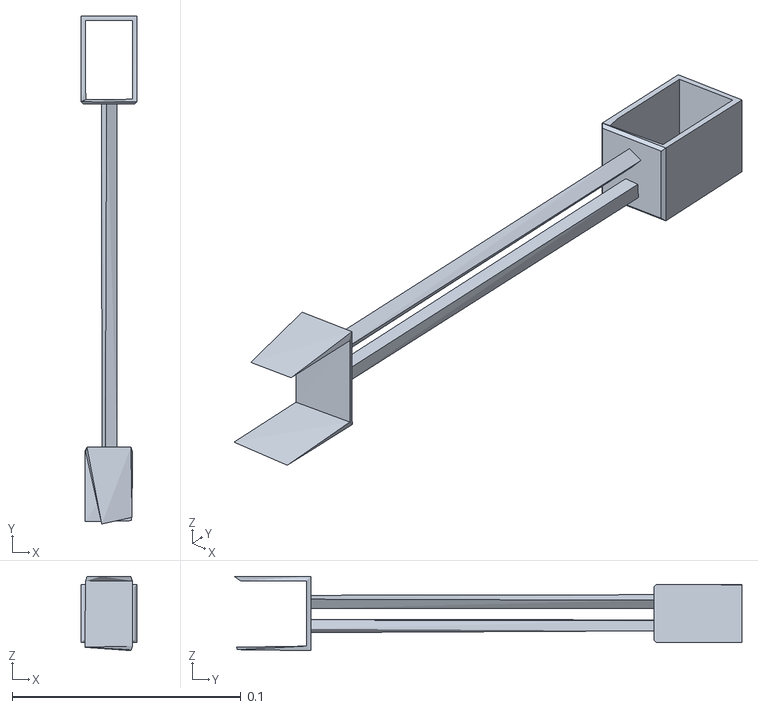
[picture p44: CAD file, 2026-08-31]
simulation/assets/arm_length_15cm.stl
0.0245 x 0.222 x 0.0325
