CPSCourse-TUM-HN/TUM-HN-Team8_LeLamp/simulation/assets/dc15_a01_idle_cap_dummy.stl

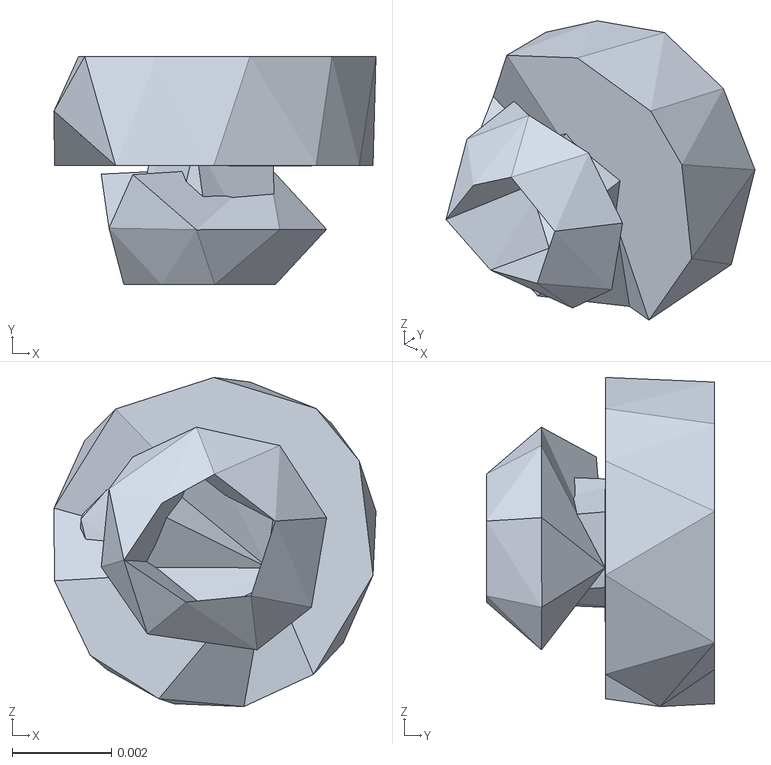
[picture p46: CAD file, 2026-08-31]
simulation/assets/dc15_a01_idle_cap_dummy.stl
0.00649 x 0.0046 x 0.00663
