CPSCourse-TUM-HN/TUM-HN-Team8_LeLamp/simulation/assets/b3b_eh.stl

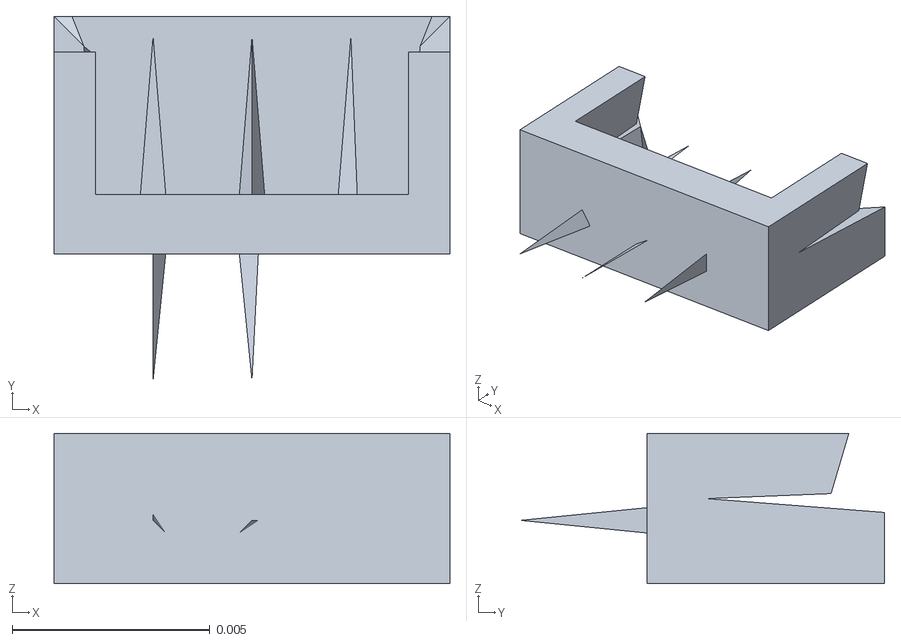
[picture p47: CAD file, 2026-08-31]
simulation/assets/b3b_eh.stl
0.01 x 0.0092 x 0.0038
