CPSCourse-TUM-HN/TUM-HN-Team8_LeLamp/simulation/assets/angle_joint.stl

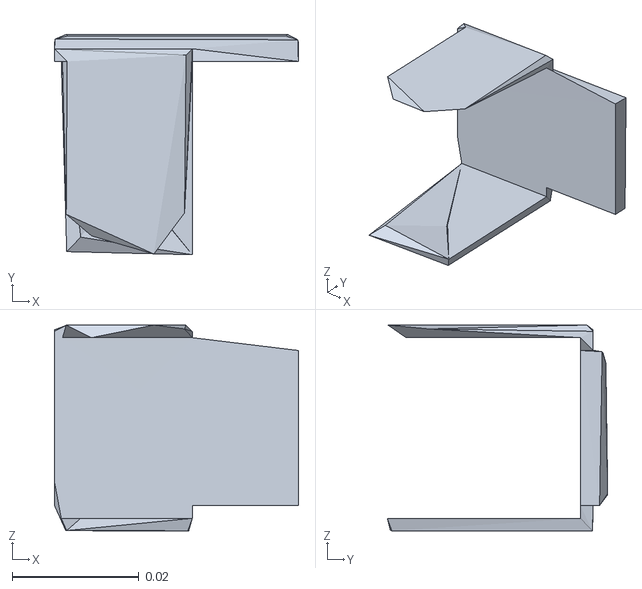
[picture p48: CAD file, 2026-08-31]
simulation/assets/angle_joint.stl
0.0385 x 0.0348 x 0.0325
