CPSCourse-TUM-HN/TUM-HN-Team8_LeLamp/simulation/assets/dc15_a01_horn_idle2_dummy.stl

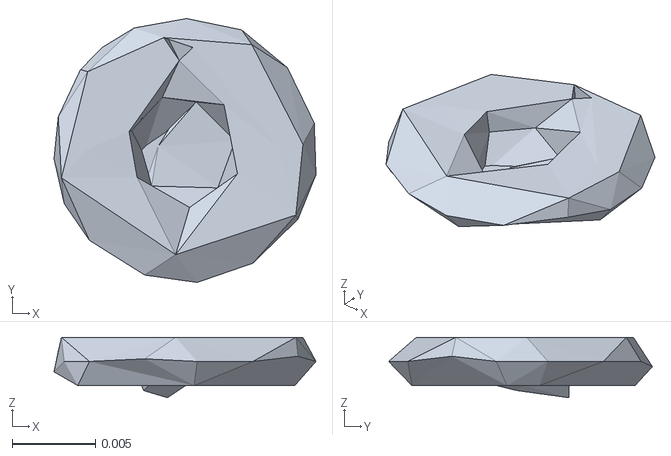
[picture p49: CAD file, 2026-08-31]
simulation/assets/dc15_a01_horn_idle2_dummy.stl
0.0157 x 0.0159 x 0.00363
