CPSCourse-TUM-HN/TUM-HN-Team8_LeLamp/simulation/assets/bts2_m2_6x8.stl

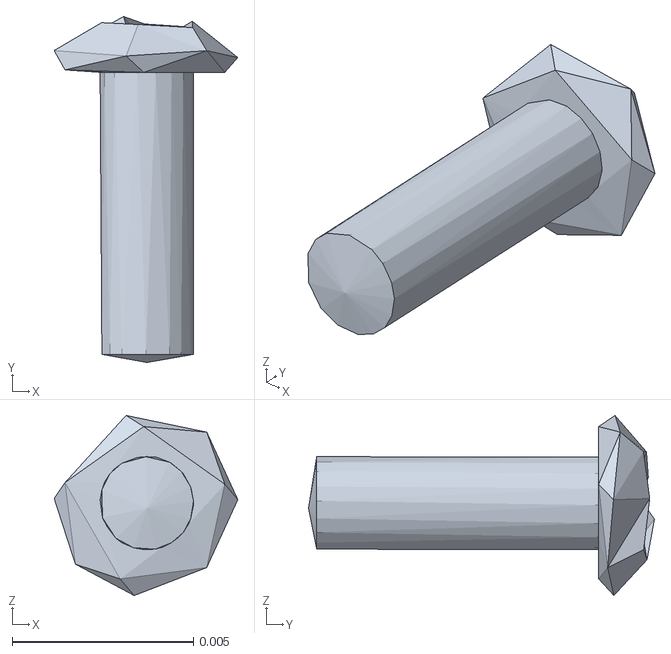
[picture p50: CAD file, 2026-08-31]
simulation/assets/bts2_m2_6x8.stl
0.00506 x 0.00954 x 0.00497
