CPSCourse-TUM-HN/TUM-HN-Team8_LeLamp/simulation/assets/lamp_base_cover.stl

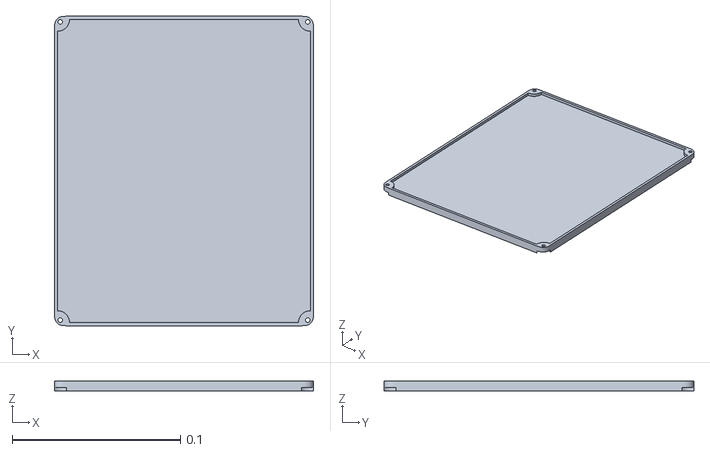
[picture p51: CAD file, 2026-08-31]
simulation/assets/lamp_base_cover.stl
0.154 x 0.184 x 0.006
