CPSCourse-TUM-HN/TUM-HN-Team8_LeLamp/simulation/assets/lamparm__elbow_wrist.stl

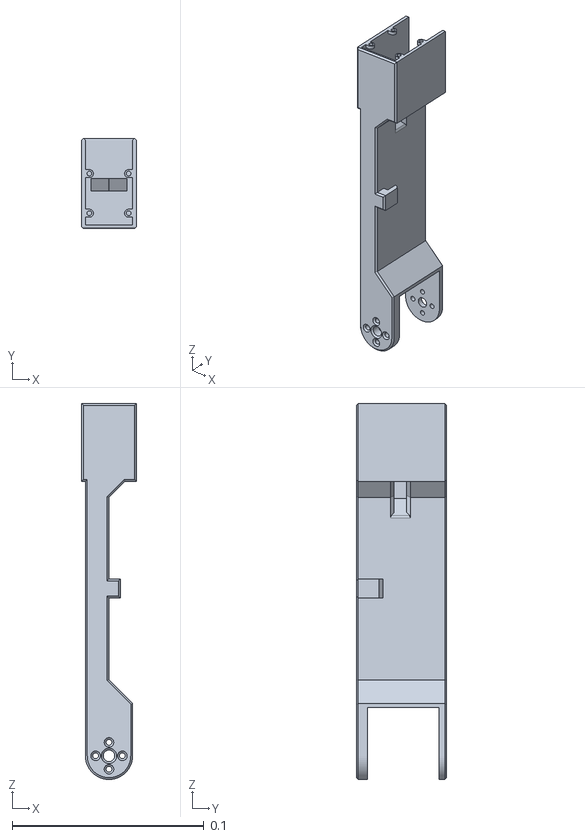
[picture p52: CAD file, 2026-08-31]
simulation/assets/lamparm__elbow_wrist.stl
0.0287 x 0.0472 x 0.196
