CPSCourse-TUM-HN/TUM-HN-Team8_LeLamp/(list of files, cad)

Other CAD files:
3D/print_ready/AILamp_Current_3D_Print_Files/STL_Exports/AILamp_Electronics_Side_Deck.stl
simulation/assets/ailamp_adapters/AILamp_Electronics_Side_Deck.stl
3D/AILamp_Adapters/AILamp_Cable_Clip_6mm.3mf
simulation/assets/ailamp_adapters/AILamp_Jetson_Nano_Base_Tray.stl
3D/AILamp_Adapters/AILamp_Cable_Clip_10mm.3mf
simulation/assets/ailamp_adapters/AILamp_Base_Arm_Link_Boot.stl
3D/print_ready/AILamp_Current_3D_Print_Files/STL_Exports/AILamp_Base_Arm_Link_Boot.stl
simulation/assets/ailamp_adapters/AILamp_Cable_Clip_10mm.stl
3D/print_ready/AILamp_Current_3D_Print_Files/Required_3MF/AILamp_Cable_Clip_6mm.3mf
3D/print_ready/AILamp_Current_3D_Print_Files/STL_Exports/AILamp_Cable_Clip_6mm.stl
3D/AILamp_Adapters/AILamp_LampBase_Electronics_Cover.3mf
3D/print_ready/AILamp_Current_3D_Print_Files/STL_Exports/AILamp_Jetson_Nano_Base_Tray.stl
simulation/assets/ailamp_adapters/AILamp_LampBase_Electronics_Shell.stl
3D/print_ready/AILamp_Current_3D_Print_Files/Required_3MF/AILamp_LampBase_Electronics_Shell.3mf
3D/print_ready/AILamp_Current_3D_Print_Files/Required_3MF/AILamp_Cable_Clip_10mm.3mf
3D/AILamp_Adapters/AILamp_Base_Arm_Link_Boot.stl
3D/AILamp_Adapters/AILamp_Cable_Clip_6mm.stl
3D/AILamp_Adapters/AILamp_Electronics_Side_Deck.stl
3D/AILamp_Adapters/AILamp_Jetson_Nano_Base_Tray.stl
3D/AILamp_Adapters/AILamp_LampBase_Electronics_Cover.stl
3D/AILamp_Adapters/AILamp_LampBase_Electronics_Shell.stl
simulation/assets/lamphead.stl
