CPSCourse-TUM-HN/TUM-HN-Team8_LeLamp/docs/media/ailamp_assembled_sim.png

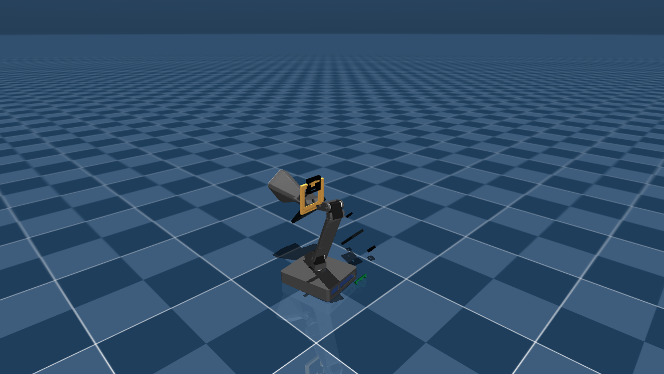
docs/media/ailamp_assembled_sim.png
