CPSCourse-TUM-HN/TUM-HN-Team8_LeLamp/ailamp_runtime/ailamp/services/vision_runtime.py

from __future__ import annotations

from dataclasses import dataclass
from datetime import datetime, timezone
import json
import logging
from pathlib import Path
import tempfile
import time
from typing import Callable, Iterator

from ailamp.config import HardwareConfig
from ailamp.models import BehaviorAction, BoundingBox, VisionEvent, VisionEventType
from ailamp.paths import resolve_project_path
from ailamp.services.api_vision import APIVisionService
from ailamp.services.behavior import BehaviorService
from ailamp.services.camera import CameraService
from ailamp.services.decision import AIDecision, DecisionService
from ailamp.services.led_serial import LEDSerialService
from ailamp.services.motor import JointDeltaCommand, MotorService
from ailamp.services.pose_gesture import PoseDetectorService, classify_pose_gesture
from ailamp.services.vision import DetectorService, classify_person_position


logger = logging.getLogger(__name__)


# Errors classified as transient (camera lost a frame, USB hiccup, etc.) — retry with backoff.
# Anything else propagates immediately so the operator sees the real failure.
_TRANSIENT_EXCEPTIONS: tuple[type[BaseException], ...] = (OSError, TimeoutError, ConnectionError)
_DEFAULT_RETRY_DELAYS_S: tuple[float, ...] = (0.05, 0.2, 0.5)


def _utc_now() -> str:
    return datetime.now(timezone.utc).isoformat()


def _bbox_to_dict(bbox: BoundingBox | None) -> dict[str, float | str] | None:
    if bbox is None:
        return None
    return {
        "x": bbox.x,
        "y": bbox.y,
        "width": bbox.width,
        "height": bbox.height,
        "confidence": bbox.confidence,
        "label": bbox.label,
    }


def _bbox_from_dict(raw: dict | None) -> BoundingBox | None:
    if not isinstance(raw, dict):
        return None
    return BoundingBox(
        float(raw["x"]),
        float(raw["y"]),
        float(raw["width"]),
        float(raw["height"]),
        float(raw["confidence"]),
        str(raw.get("label", "person")),
    )


def _joint_deltas_to_dict(commands: tuple[JointDeltaCommand, ...]) -> list[dict[str, float | str]]:
    return [{"joint": command.joint, "delta_deg": command.delta_deg} for command in commands]


def _joint_deltas_from_dict(raw: list[dict] | None) -> tuple[JointDeltaCommand, ...]:
    if not isinstance(raw, list):
        return ()
    return tuple(JointDeltaCommand(str(item["joint"]), float(item["delta_deg"])) for item in raw)


def _decision_to_dict(decision: AIDecision | None) -> dict | None:
    if decision is None:
        return None
    return {
        "motion": decision.motion,
        "rgb": list(decision.rgb),
        "reason": decision.reason,
        "joint_deltas": _joint_deltas_to_dict(decision.joint_deltas),
        "semantic_reason": decision.semantic_reason,
    }


@dataclass(frozen=True)
class VisionSnapshot:
    event: VisionEvent
    action: BehaviorAction
    updated_at: str
    frame_index: int
    decision: AIDecision | None = None

    def to_dict(self) -> dict:
        return {
            "updated_at": self.updated_at,
            "frame_index": self.frame_index,
            "event": {
                "event_type": self.event.event_type.value,
                "confidence": self.event.confidence,
                "bbox": _bbox_to_dict(self.event.bbox),
                "normalized_offset": self.event.normalized_offset,
                "area_ratio": self.event.area_ratio,
                "semantic_reason": self.event.semantic_reason,
            },
            "action": {
                "motion": self.action.motion,
                "rgb": list(self.action.rgb),
                "priority": self.action.priority,
            },
            "decision": _decision_to_dict(self.decision),
        }

    @classmethod
    def from_dict(cls, raw: dict) -> VisionSnapshot:
        event_raw = raw["event"]
        event = VisionEvent(
            event_type=VisionEventType(event_raw["event_type"]),
            confidence=float(event_raw.get("confidence", 0.0)),
            bbox=_bbox_from_dict(event_raw.get("bbox")),
            normalized_offset=float(event_raw.get("normalized_offset", 0.0)),
            area_ratio=float(event_raw.get("area_ratio", 0.0)),
            semantic_reason=str(event_raw.get("semantic_reason", "")),
        )
        action_raw = raw["action"]
        action = BehaviorAction(
            event=event,
            motion=str(action_raw["motion"]),
            rgb=tuple(int(value) for value in action_raw["rgb"]),
            priority=int(action_raw.get("priority", 1)),
        )
        decision_raw = raw.get("decision")
        decision = None
        if isinstance(decision_raw, dict):
            decision = AIDecision(
                event=event,
                motion=str(decision_raw["motion"]),
                rgb=tuple(int(value) for value in decision_raw["rgb"]),
                reason=str(decision_raw.get("reason", "")),
                joint_deltas=_joint_deltas_from_dict(decision_raw.get("joint_deltas")),
                semantic_reason=str(decision_raw.get("semantic_reason", "")),
            )
        return cls(
            event=event,
            action=action,
            updated_at=str(raw["updated_at"]),
            frame_index=int(raw.get("frame_index", 0)),
            decision=decision,
        )


class VisionStateStore:
    def __init__(self, path: str | Path):
        self.path = resolve_project_path(path)

    def write(self, snapshot: VisionSnapshot) -> None:
        self.path.parent.mkdir(parents=True, exist_ok=True)
        with tempfile.NamedTemporaryFile("w", dir=self.path.parent, prefix=f".{self.path.name}.", suffix=".tmp", delete=False) as handle:
            handle.write(json.dumps(snapshot.to_dict(), indent=2) + "\n")
            temp_path = Path(handle.name)
        temp_path.replace(self.path)

    def read(self) -> VisionSnapshot | None:
        if not self.path.exists():
            return None
        try:
            raw = json.loads(self.path.read_text())
            return VisionSnapshot.from_dict(raw)
        except (OSError, KeyError, TypeError, ValueError, json.JSONDecodeError):
            return None


@dataclass(frozen=True)
class VisionLoopResult:
    snapshot: VisionSnapshot
    applied: bool

    def format(self) -> str:
        action = self.snapshot.action
        event = self.snapshot.event
        decision = self.snapshot.decision
        deltas = ""
        if decision is not None and decision.joint_deltas:
            deltas = " joint_deltas=" + ",".join(f"{command.joint}:{command.delta_deg:+.2f}" for command in decision.joint_deltas)
        return (
            f"frame={self.snapshot.frame_index} event={event.event_type.value} "
            f"confidence={event.confidence:.2f} motion={action.motion} rgb={action.rgb}{deltas} applied={self.applied}"
        )


class VisionRuntime:
    def __init__(
        self,
        config: HardwareConfig,
        *,
        camera: object | None = None,
        detector: object | None = None,
        behavior: BehaviorService | None = None,
        decision_service: DecisionService | None = None,
        state_store: VisionStateStore | None = None,
        led_service: object | None = None,
        motor_service: object | None = None,
        pose_detector: object | None = None,
        api_vision: object | None = None,
        clock: Callable[[], float] = time.monotonic,
        retry_delays_s: tuple[float, ...] = _DEFAULT_RETRY_DELAYS_S,
    ):
        self.config = config
        self.backend = config.vision.backend
        self.camera = camera or CameraService(
            config.camera.device_path,
            config.camera.width,
            config.camera.height,
            config.camera.fps,
            config.camera.pixel_format,
        )
        self.detector = detector or (None if self.backend == "api_hybrid" else DetectorService(config.vision.model, config.vision.confidence))
        self.pose_detector = pose_detector
        if self.pose_detector is None and detector is None and self.backend != "api_hybrid" and config.vision.pose_enabled:
            self.pose_detector = PoseDetectorService(config.vision.pose_model, config.vision.confidence)
        self.api_vision = api_vision
        if self.api_vision is None and self.backend == "api_hybrid":
            self.api_vision = APIVisionService(
                model=config.vision.api_model,
                interval_s=config.vision.api_interval_s,
                confidence_threshold=config.vision.confidence,
                image_max_px=config.vision.api_image_max_px,
                timeout_s=config.vision.api_timeout_s,
                event_ttl_s=config.vision.api_event_ttl_s,
                clock=clock,
            )
        self.behavior = behavior or BehaviorService.from_config(config)
        self.decision_service = decision_service or DecisionService(behavior=self.behavior)
        self.state_store = state_store or VisionStateStore(config.runtime.vision_state_file)
        self.led_service = led_service
        self.motor_service = motor_service
        self.clock = clock
        self._frame_index = 0
        self._last_applied_event: VisionEventType | None = None
        self._last_applied_time = -1_000_000.0
        self._last_seen_person = False
        self._retry_delays_s = retry_delays_s
        self.errors_total = 0
        self.last_error: str | None = None

    def open(self, *, with_outputs: bool = False) -> None:
        self.camera.open()
        if self.backend == "api_hybrid":
            if self.api_vision is None:
                raise RuntimeError("api_hybrid backend is not configured")
            self.api_vision.load()
        elif self.detector is not None:
            self.detector.load()
        if self.backend != "api_hybrid" and self.pose_detector is not None:
            self.pose_detector.load()
        if with_outputs:
            if self.led_service is None:
                self.led_service = LEDSerialService(
                    self.config.led.port,
                    self.config.led.count,
                    self.config.led.baudrate,
                )
            if self.motor_service is None:
                self.motor_service = MotorService(
                    self.config.motors.port,
                    self.config.system.project_name.lower(),
                    resolve_project_path(self.config.simulation.recordings_dir),
                )
            self.led_service.connect()
            self.motor_service.connect()

    def close(self) -> None:
        if self.motor_service is not None:
            self.motor_service.close()
        if self.led_service is not None:
            self.led_service.close()
        self.camera.close()

    def step(self, *, apply_outputs: bool = False) -> VisionLoopResult:
        """Run a supervised step: transient IO errors retry with backoff and emit a NO_PERSON snapshot."""
        attempts = (None,) + self._retry_delays_s
        for delay in attempts:
            if delay is not None:
                time.sleep(delay)
            try:
                return self._step_unsafe(apply_outputs=apply_outputs)
            except _TRANSIENT_EXCEPTIONS as exc:
                self.errors_total += 1
                self.last_error = f"{type(exc).__name__}: {exc}"
                logger.warning(
                    "VisionRuntime.step transient error frame=%d attempt_delay=%s err=%s",
                    self._frame_index, delay, self.last_error,
                )
                continue
        # All retries exhausted — surface a NO_PERSON snapshot tagged with the error so the
        # state file reflects degraded health, then keep the loop alive.
        logger.error(
            "VisionRuntime.step gave up after %d retries frame=%d err=%s",
            len(self._retry_delays_s), self._frame_index, self.last_error,
        )
        event = VisionEvent(VisionEventType.NO_PERSON, semantic_reason=f"step_error:{self.last_error}")
        decision = AIDecision(
            event=event, motion="idle", rgb=(30, 30, 80),
            reason=f"step_error:{self.last_error}",
            semantic_reason=event.semantic_reason,
        )
        action = BehaviorAction(event=event, motion=decision.motion, rgb=decision.rgb)
        snapshot = VisionSnapshot(
            event=event, action=action, updated_at=_utc_now(),
            frame_index=self._frame_index, decision=decision,
        )
        try:
            self.state_store.write(snapshot)
        except OSError as state_exc:
            logger.warning("failed to write degraded state snapshot: %s", state_exc)
        self._frame_index += 1
        return VisionLoopResult(snapshot=snapshot, applied=False)

    def _step_unsafe(self, *, apply_outputs: bool = False) -> VisionLoopResult:
        frame = self.camera.read()
        if self.backend == "api_hybrid":
            if self.api_vision is None:
                raise RuntimeError("api_hybrid backend is not configured")
            event = self._choose_event(self.api_vision.detect_event(frame), None)
        else:
            bbox = self.detector.detect_person(frame) if frame is not None and self.detector is not None else None
            base_event = classify_person_position(
                bbox,
                (self.config.camera.width, self.config.camera.height),
                left_threshold=self.config.vision.left_threshold,
                right_threshold=self.config.vision.right_threshold,
                close_area_ratio=self.config.vision.close_area_ratio,
                far_area_ratio=self.config.vision.far_area_ratio,
            )
            pose_event = None
            if frame is not None and bbox is not None and self.pose_detector is not None:
                pose_event = classify_pose_gesture(self.pose_detector.detect_pose(frame))
            event = self._choose_event(base_event, pose_event)
        decision = self.decision_service.decide(event)
        action = BehaviorAction(event=event, motion=decision.motion, rgb=decision.rgb)
        snapshot = VisionSnapshot(event=event, action=action, updated_at=_utc_now(), frame_index=self._frame_index, decision=decision)
        self.state_store.write(snapshot)
        applied = self._apply_if_needed(decision, apply_outputs)
        self._frame_index += 1
        return VisionLoopResult(snapshot=snapshot, applied=applied)

    def _choose_event(self, base_event: VisionEvent, pose_event: VisionEvent | None) -> VisionEvent:
        if base_event.event_type == VisionEventType.NO_PERSON:
            if base_event.semantic_reason.startswith(("api_error:", "no_frame")):
                self._last_seen_person = False
                return base_event
            if self._last_seen_person:
                self._last_seen_person = False
                return VisionEvent(VisionEventType.PERSON_LEFT_SEAT, semantic_reason=base_event.semantic_reason)
            return base_event

        self._last_seen_person = True
        if base_event.event_type == VisionEventType.PERSON_CLOSE:
            return base_event
        if pose_event is not None and pose_event.event_type not in {VisionEventType.NO_PERSON, VisionEventType.PERSON_CENTER}:
            return pose_event
        return base_event

    def run(
        self,
        *,
        max_frames: int | None = None,
        interval_s: float | None = None,
        apply_outputs: bool = False,
    ) -> Iterator[VisionLoopResult]:
        frame_limit = max_frames if max_frames is not None and max_frames > 0 else None
        interval = self.config.runtime.vision_interval_s if interval_s is None else interval_s
        while frame_limit is None or self._frame_index < frame_limit:
            yield self.step(apply_outputs=apply_outputs)
            if frame_limit is None or self._frame_index < frame_limit:
                time.sleep(max(0.0, interval))

    def _apply_if_needed(self, decision: AIDecision, apply_outputs: bool) -> bool:
        if not apply_outputs:
            return False
        if self.led_service is None or self.motor_service is None:
            raise RuntimeError("VisionRuntime outputs are not connected")
        now = self.clock()
        cooldown_elapsed = now - self._last_applied_time >= self.config.runtime.action_cooldown_s
        if decision.event.event_type == self._last_applied_event and not cooldown_elapsed:
            return False
        if decision.joint_deltas:
            self.motor_service.apply_joint_deltas(decision.joint_deltas)
            self.led_service.solid(*decision.rgb)
        else:
            self.motor_service.play(decision.motion)
            self.led_service.solid(*decision.rgb)
        self._last_applied_event = decision.event.event_type
        self._last_applied_time = now
        return True
